DTzschentke/PCBs/EmphaseMainBoard/Project Outputs for EmphaseMainBoard/Import Error Report - EmphaseMainBoard.html

Altium customize

# DXF/DWG File Import Error Report

Date | : | 2012-06-26
Time | : | 17:45:27
Elapsed Time | : | 00:00:00
PCB Filename | : | E:\Projekte\PCBs\EmphaseMainBoard\EmphaseMainBoard.PcbDoc
DXF Filename | : | E:\Orga\CI\NonlinearLabsLogo.dxf

ERROR : The file could not be processed - Can't get current mlstyle
