DTzschentke/PCBs/EmphaseMainBoard/Project Outputs for EmphaseMainBoard/Titelpage.odt

Hardware Documentation

Emphase Keyboard

- Mainboard -

V01 Rev.A 1226 DTZ

printed: 2012-07-03
