DTzschentke/PCBs/_Project/Hardware Interface Overview.pdf

# Emphase Mainboard Hardware Interface Overview

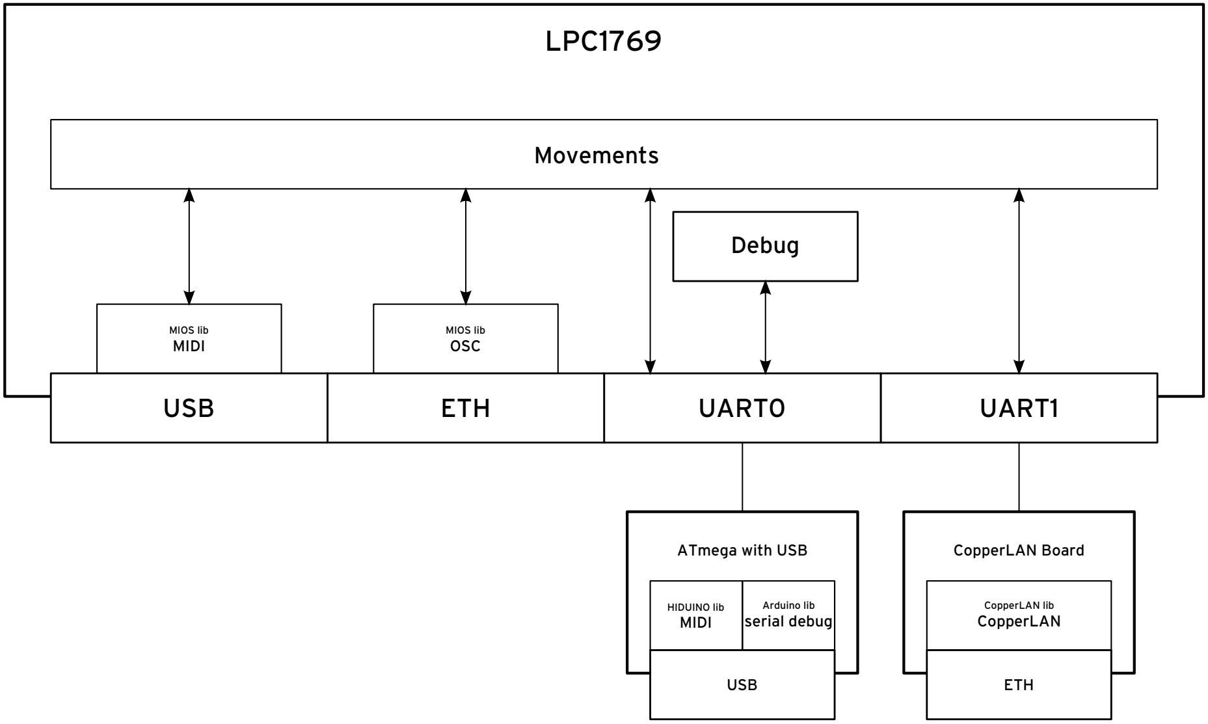
[picture p1: figure]
USB; ETH; UART0; UART1; LPC1769; MIOS lib MIDI; MIOS lib OSC; ATmega with USB; CopperLAN Board; HIDUINO lib MIDI; Arduino lib serial debug; CopperLAN lib CopperLAN; Movements; Debug

2012-07-25 DTZ
