DTzschentke/PCBs/_Project/2012-06-18_ProjektÜbersicht.pdf

# Empahse Hardware Übersicht

Abtastfrequenzen:
2 kHz - 500 µs
2.5 kHz - 400 µs
3.34 kHz - 300 µs
5 | kHz - 200 µs
10 | kHz - 100 µs

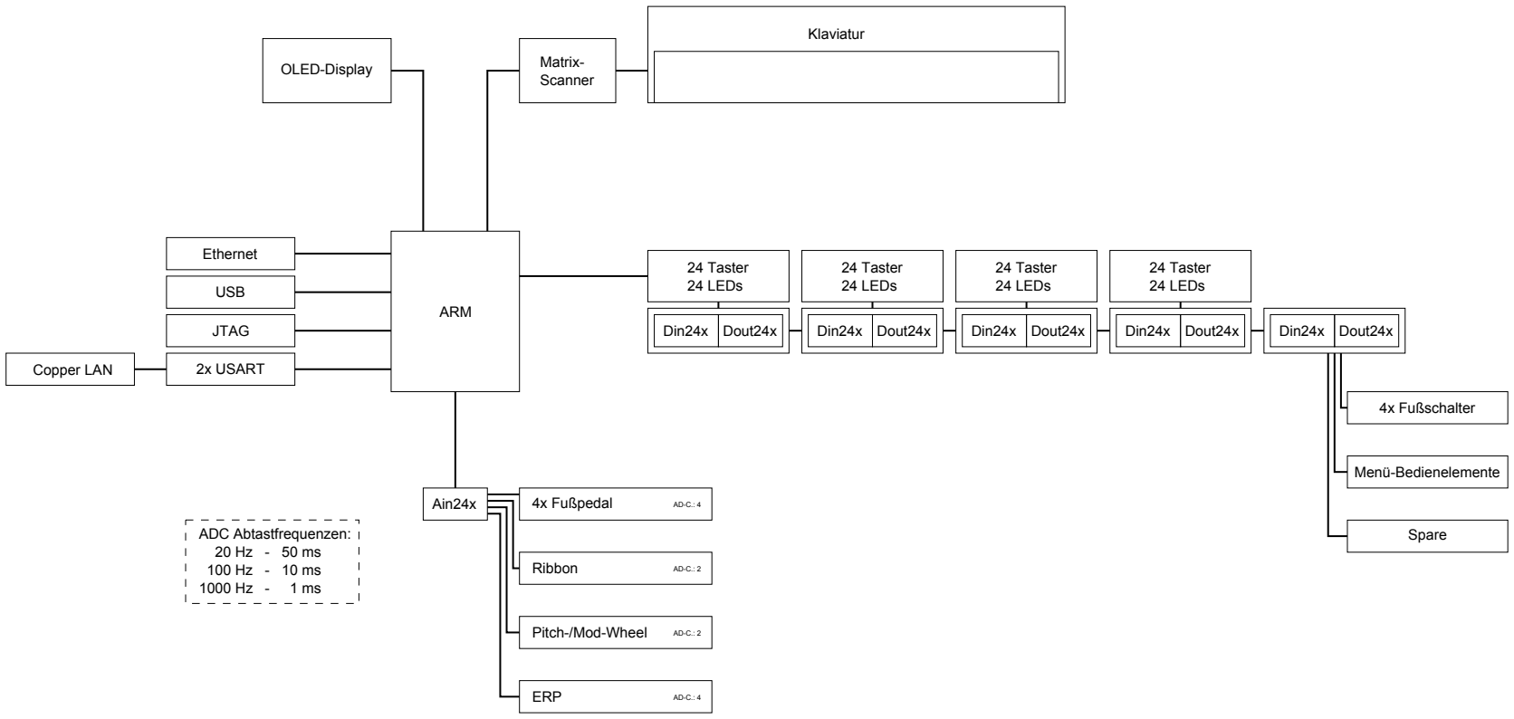
[picture p2: figure]
ARM; OLED-Display; Ethernet; USB; JTAG; Copper LAN; 2x USART; Matrix- Scanner; Klaviatur; Din24x; Dout24x; 24 Taster 24 LEDs; Spare; 4x Fußschalter; Menü-Bedienelemente; Ain24x; 4x Fußpedal; Ribbon; Pitch-/Mod-Wheel; ERP; ADC Abtastfrequenzen: 20 Hz - 50 ms 100 Hz - 10 ms

2012-06-18
