DTzschentke/PCBs/Dout32x/Dout32x.pdf

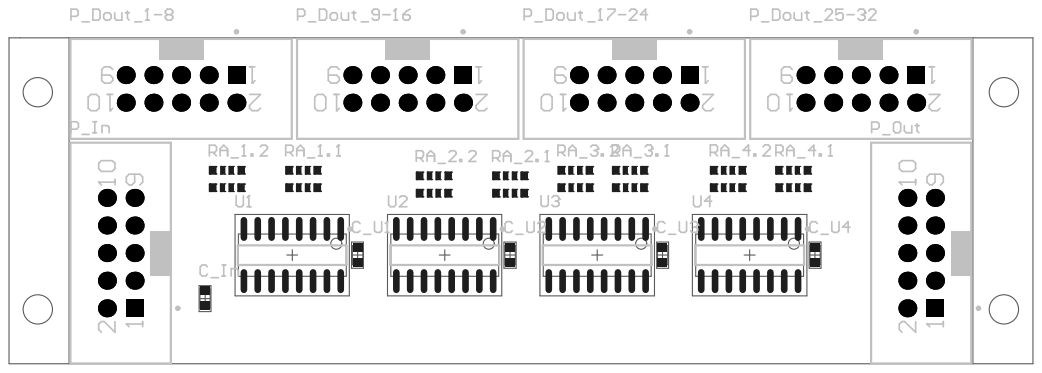
[picture p10: page 1]
