DTzschentke/PCBs/Prototype/Base Board.sch Rev.B.pdf

A

A

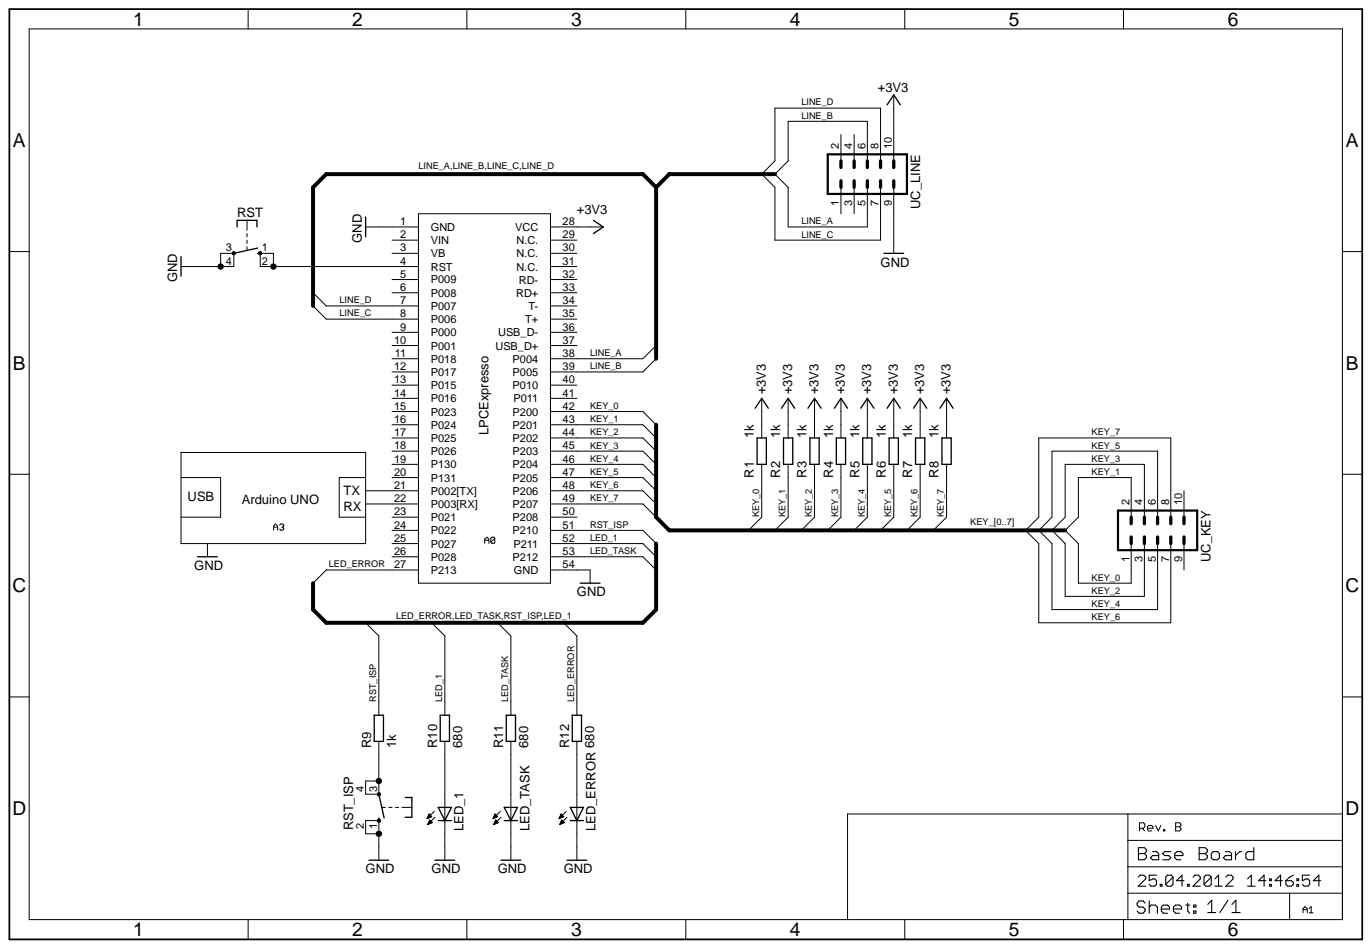
[picture p13: page 1]
