DTzschentke/PCBs/UiBoard/Job1.PDF

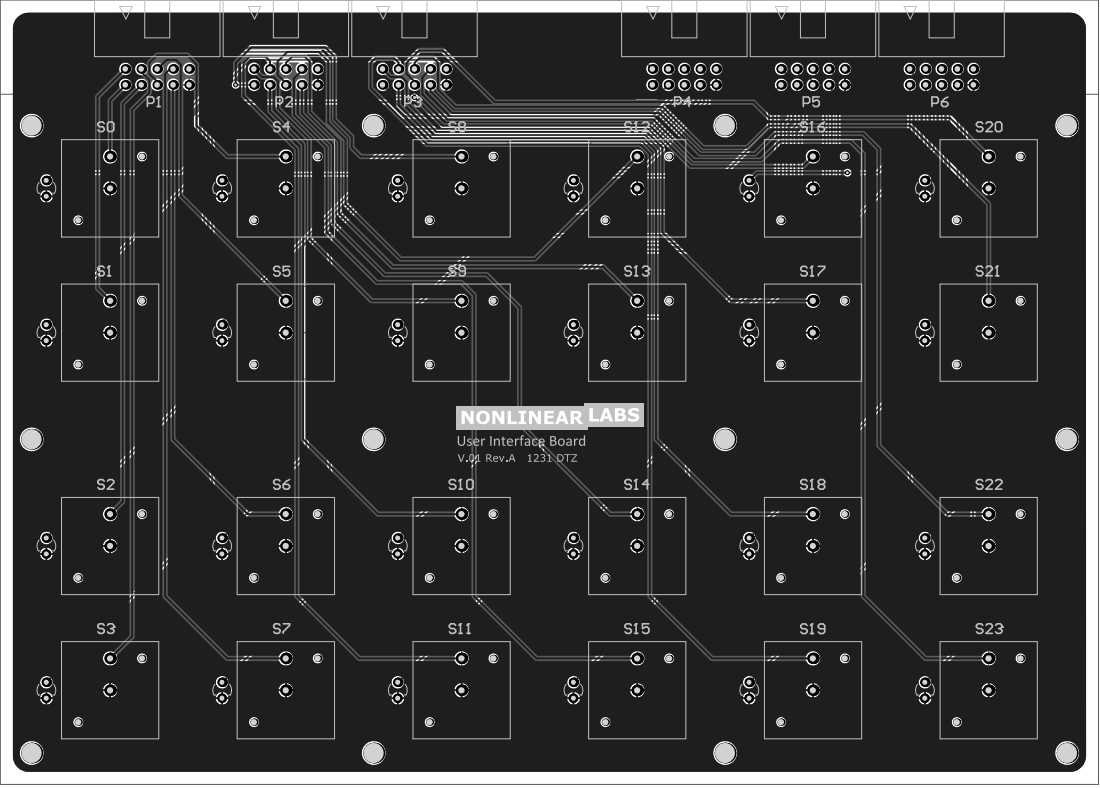
[picture p14: page 1]

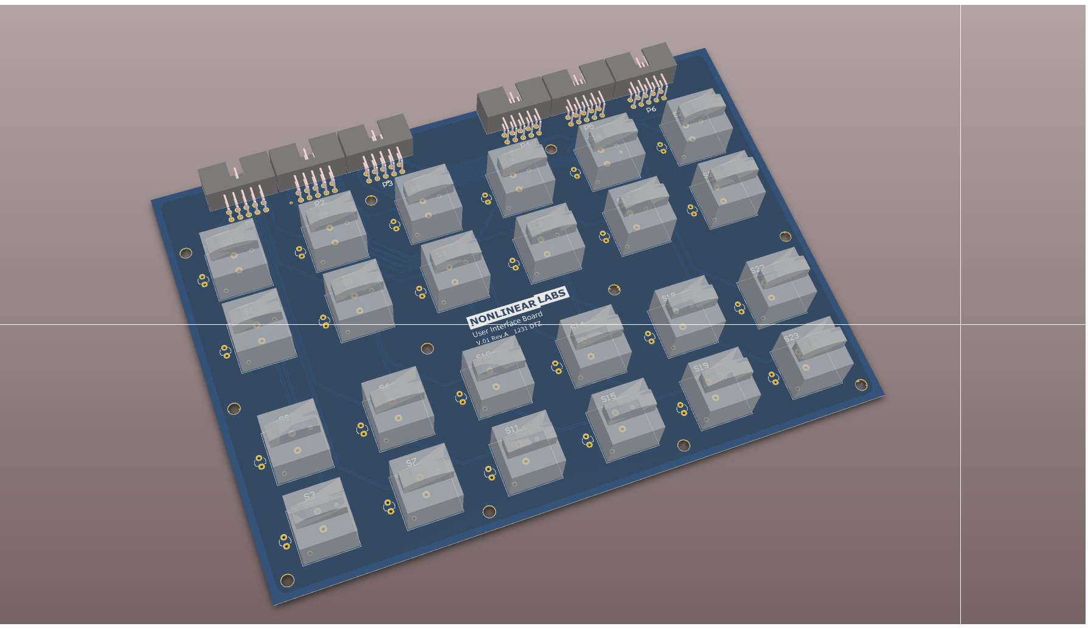
[picture p15: page 2]
