DTzschentke/PCBs/mbhp_core_lpc17_pcb_v1_0/mbhp_core_lpc17_pcb_v1_0/Bottom.pdf

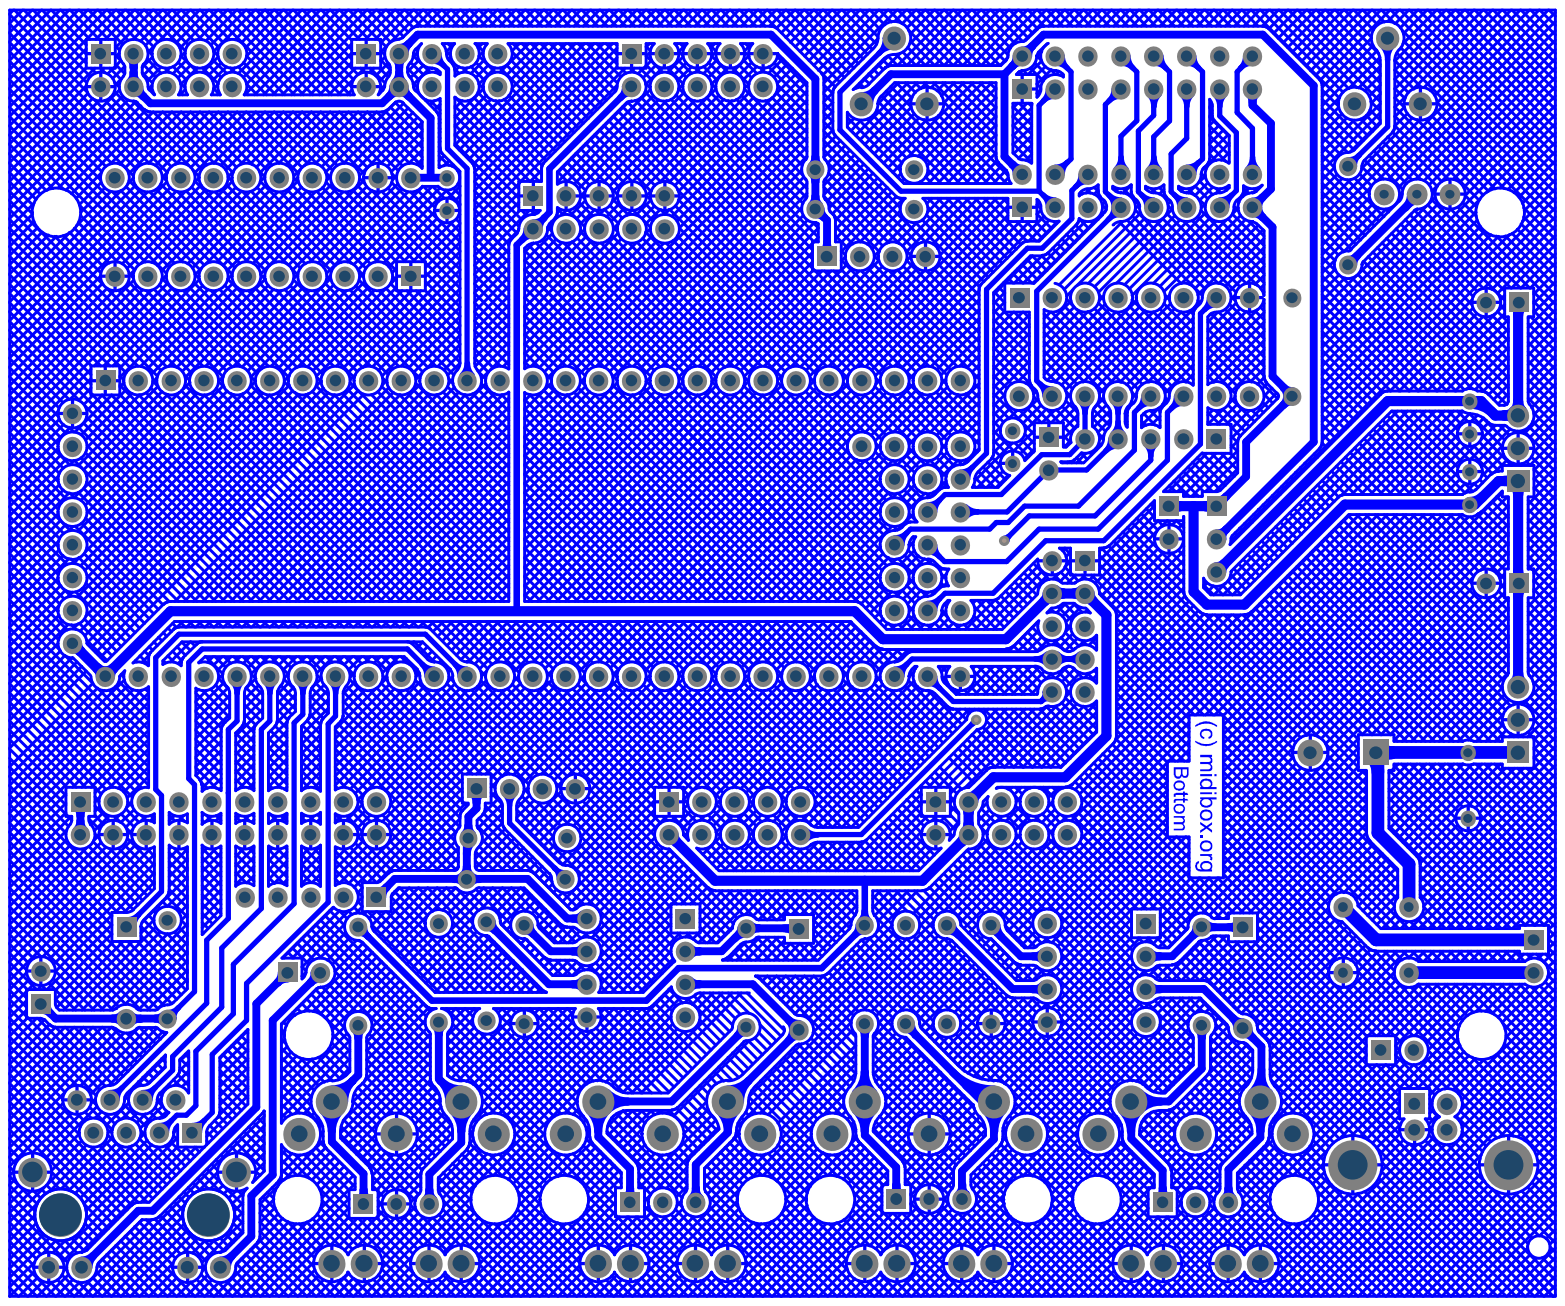
[picture p16: page 1]
