DTzschentke/PCBs/mbhp_core_lpc17_pcb_v1_0/mbhp_core_lpc17_pcb_v1_0/MBHP_CORE_LPC176x.pdf

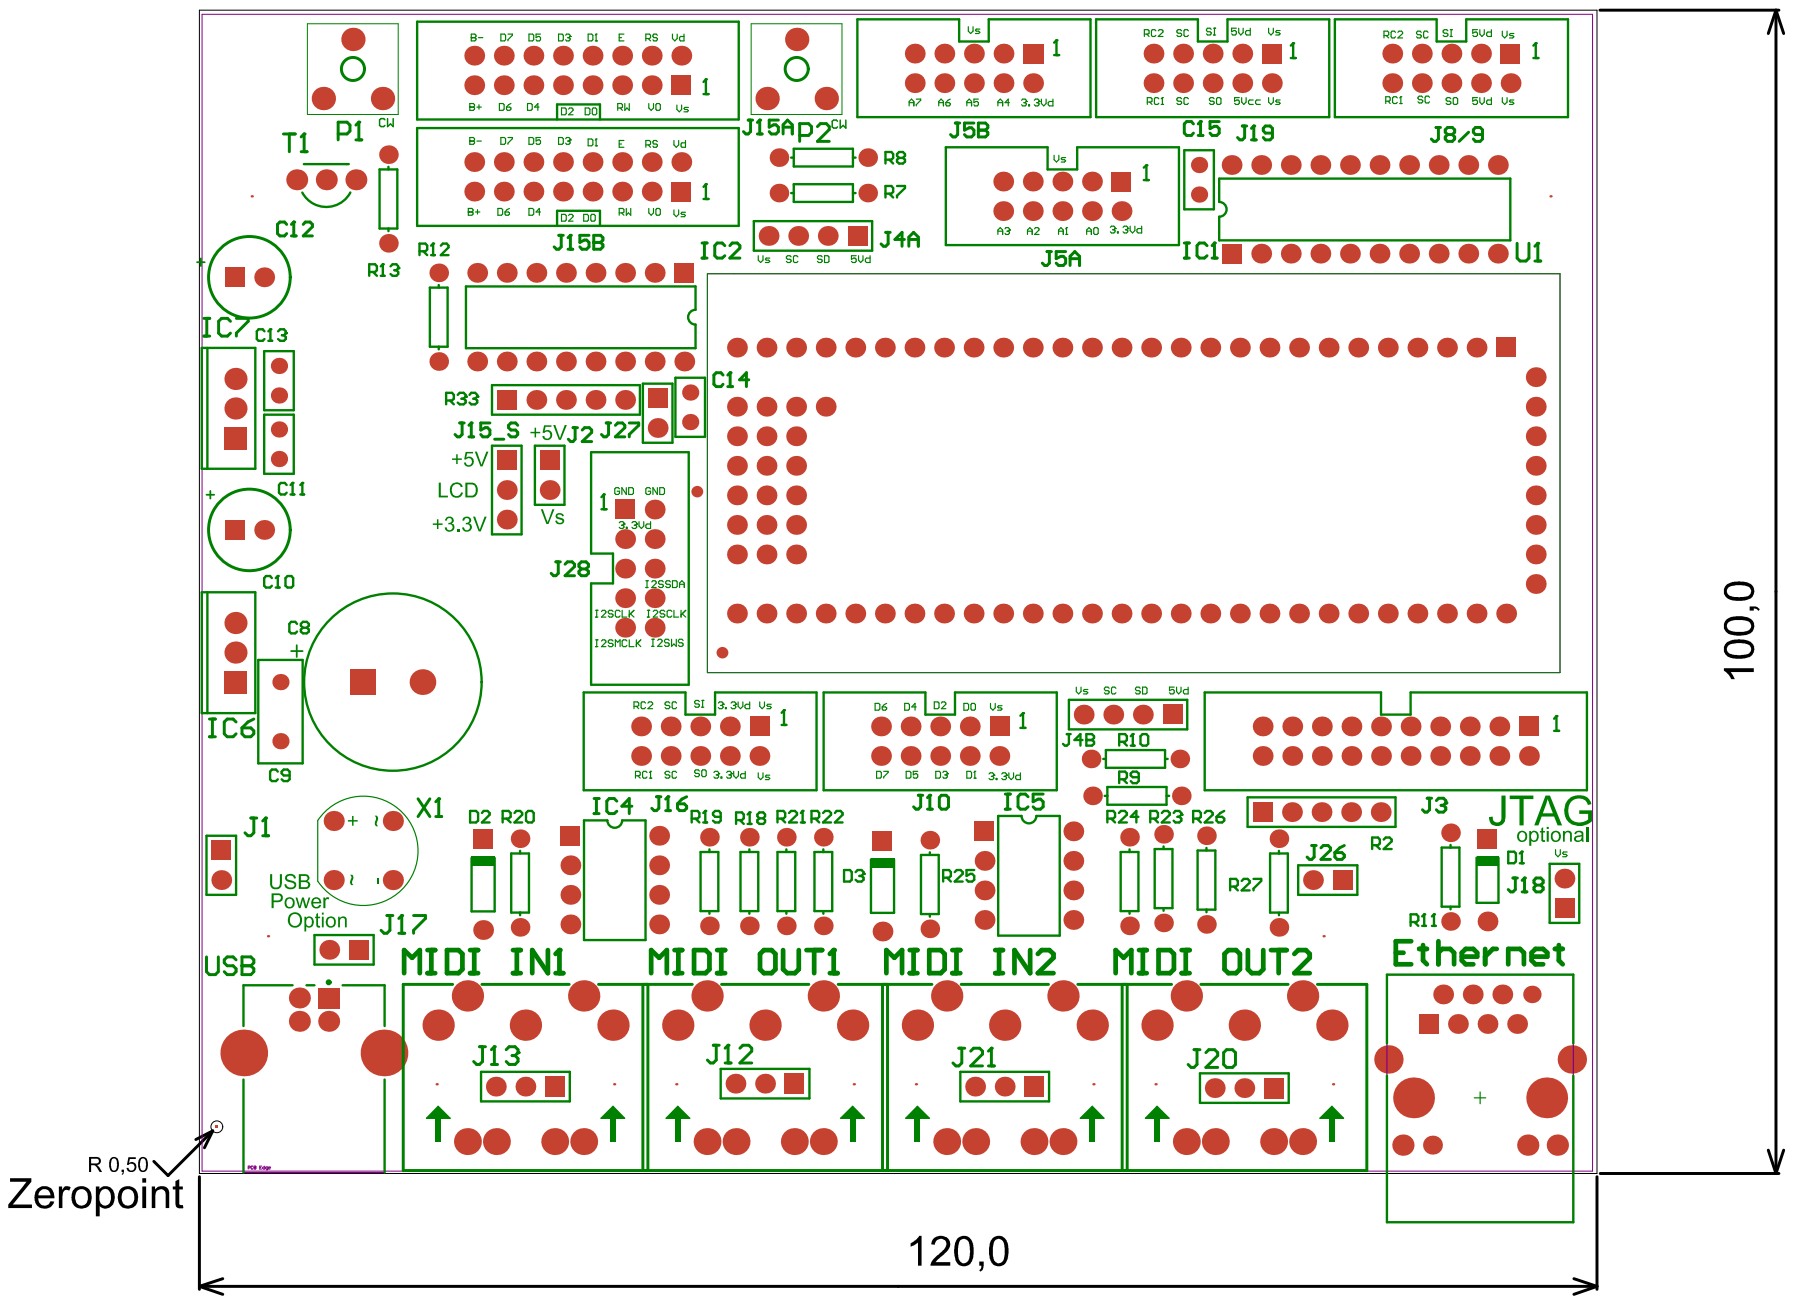
[picture p17: page 1]
