DTzschentke/PCBs/mbhp_core_lpc17_pcb_v1_0/mbhp_core_lpc17_pcb_v1_0/MBHP_CORE_LPC17x.pdf

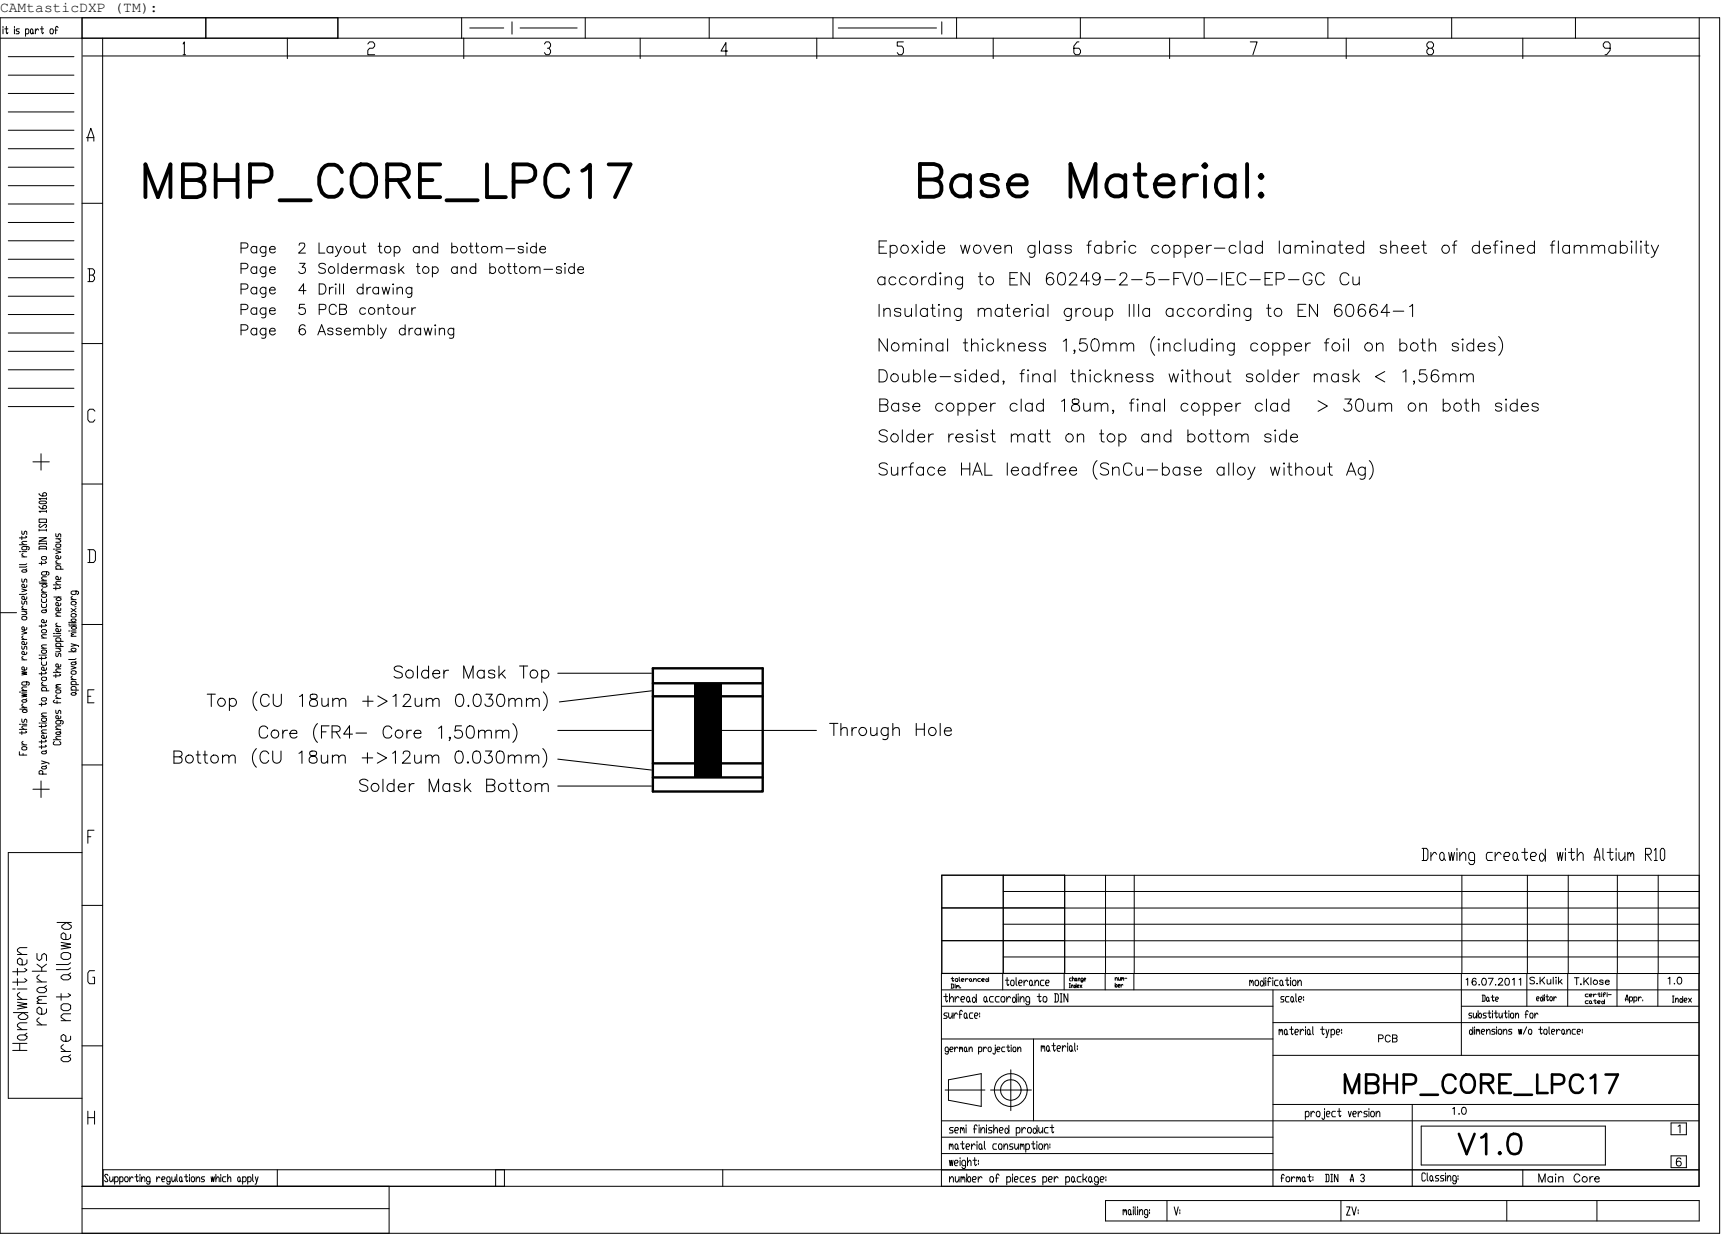
[picture p18: page 1]
CAMtasticDXP (TM):

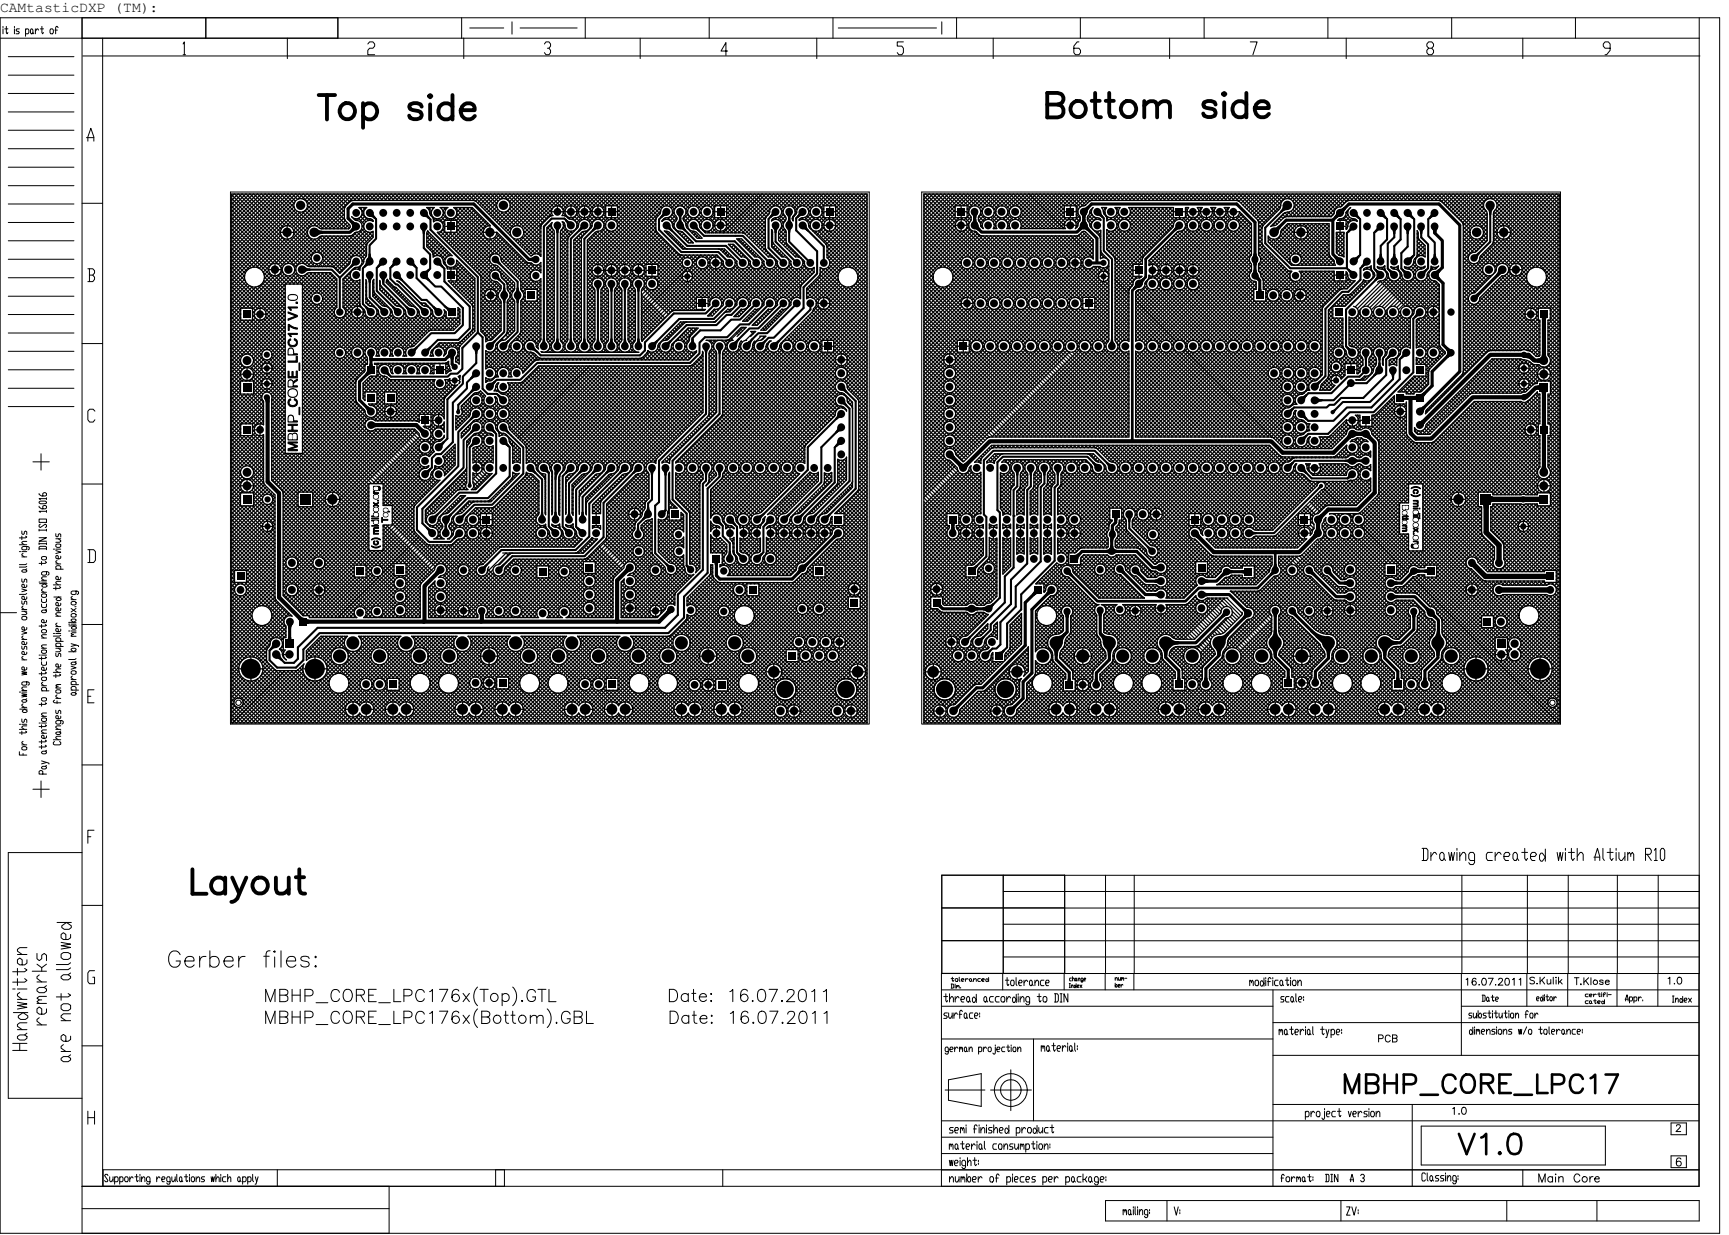
[picture p19: page 2]

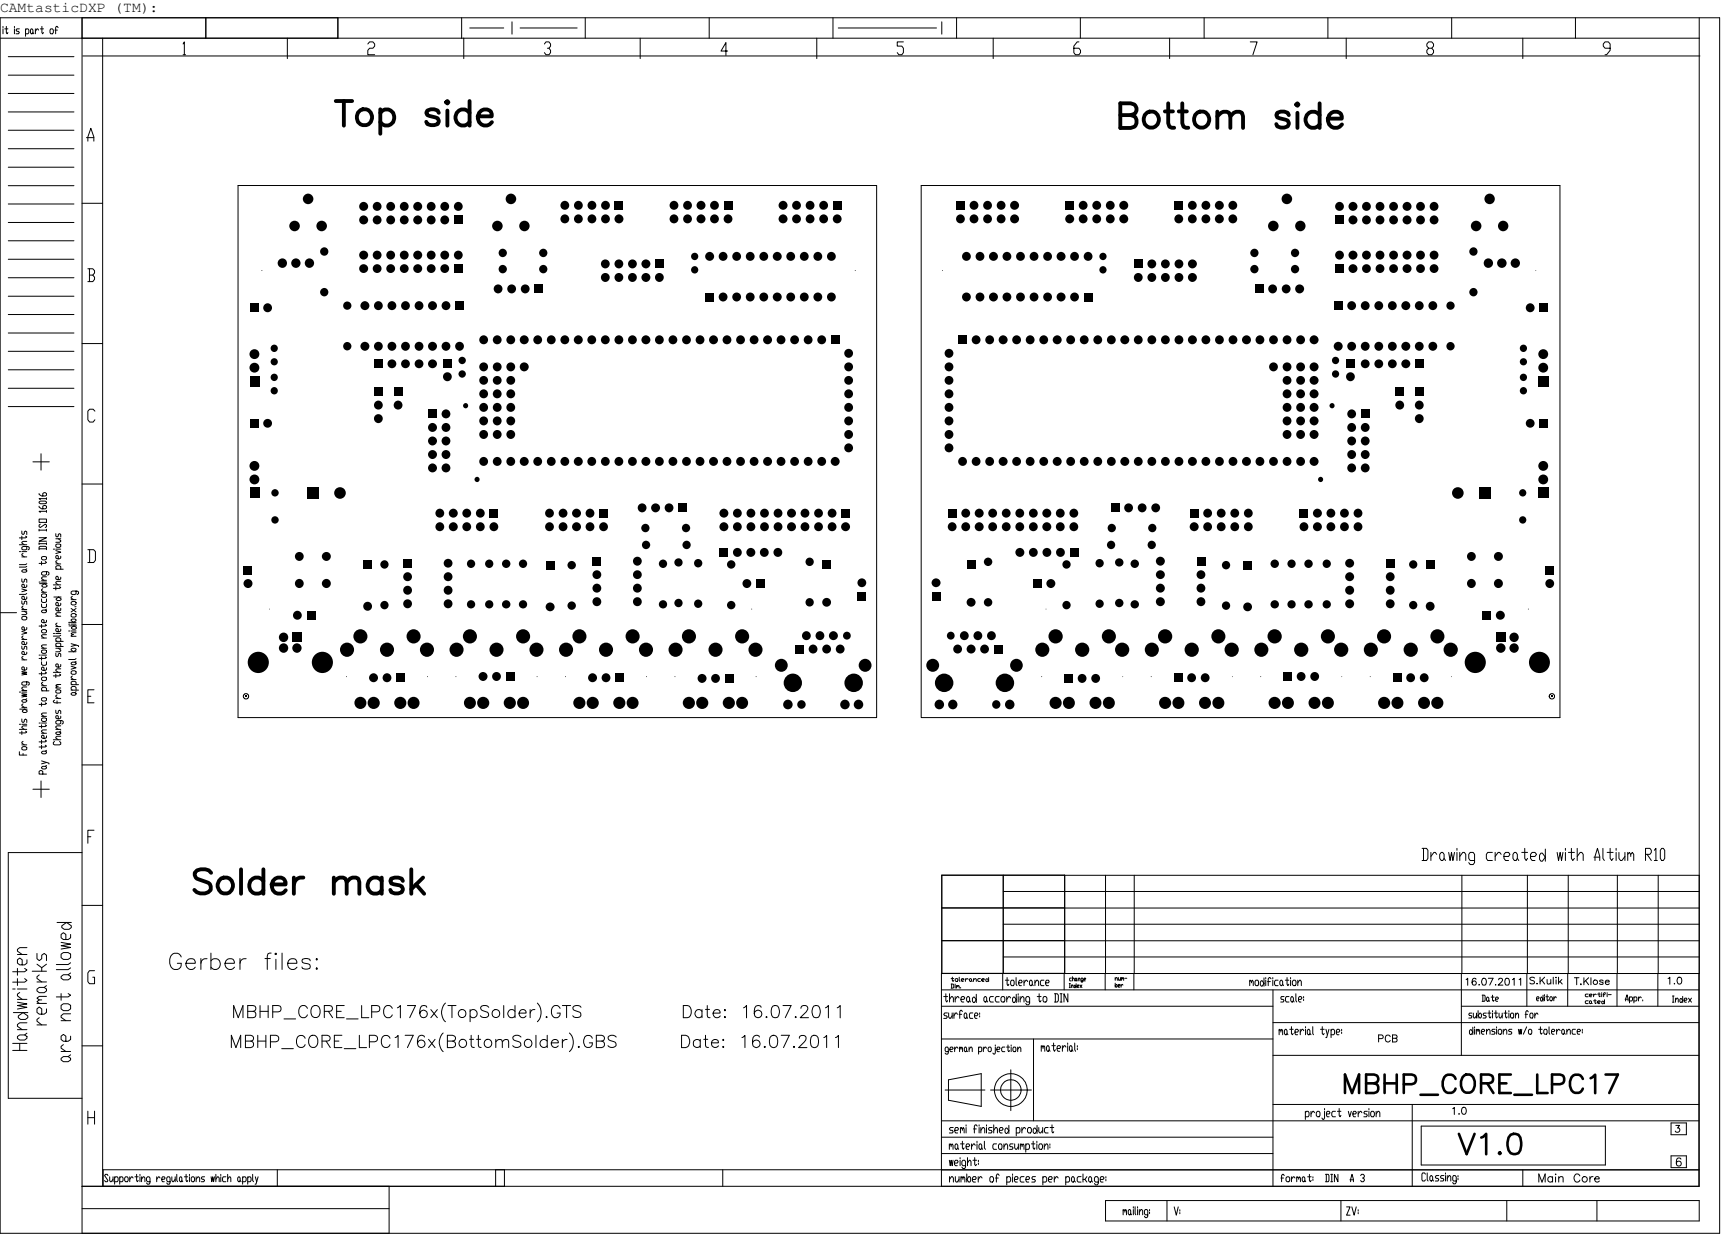
[picture p20: page 3]

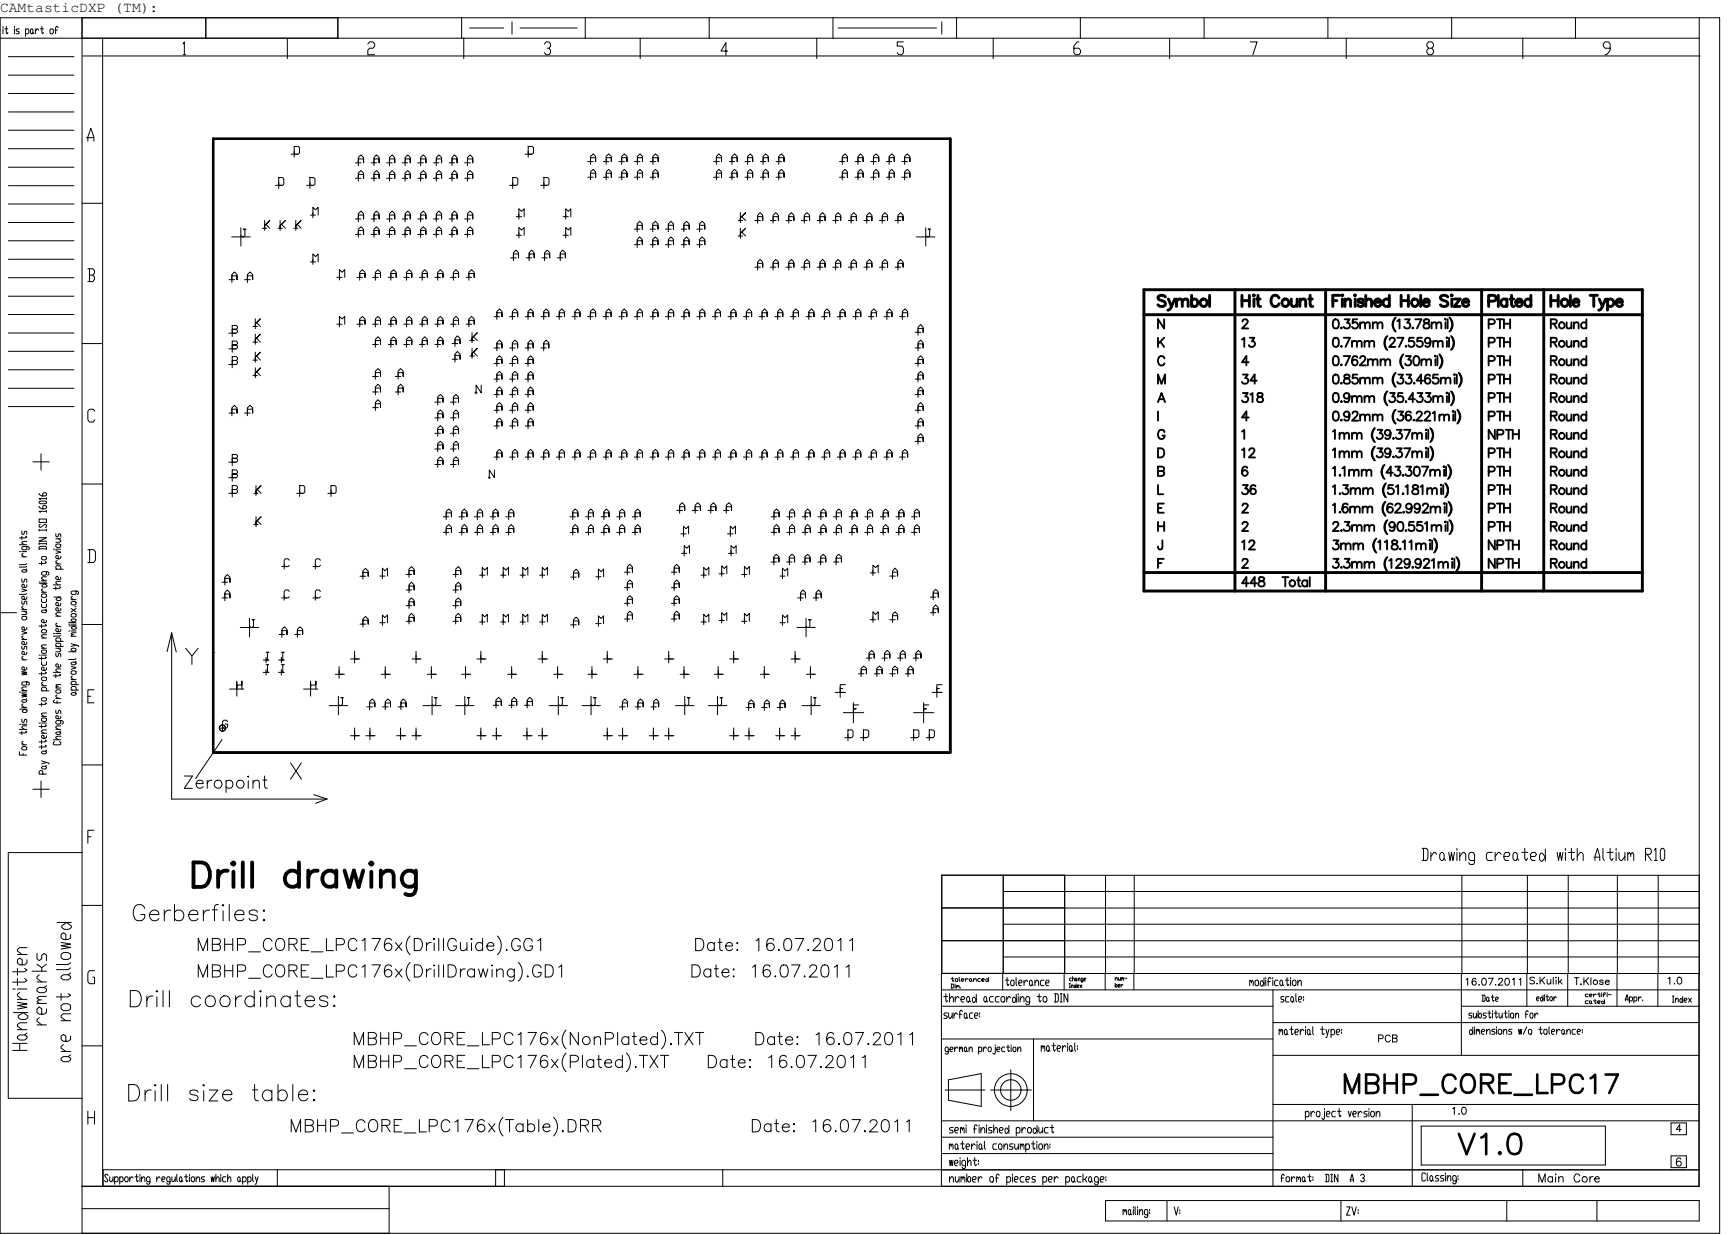
[picture p21: page 4]

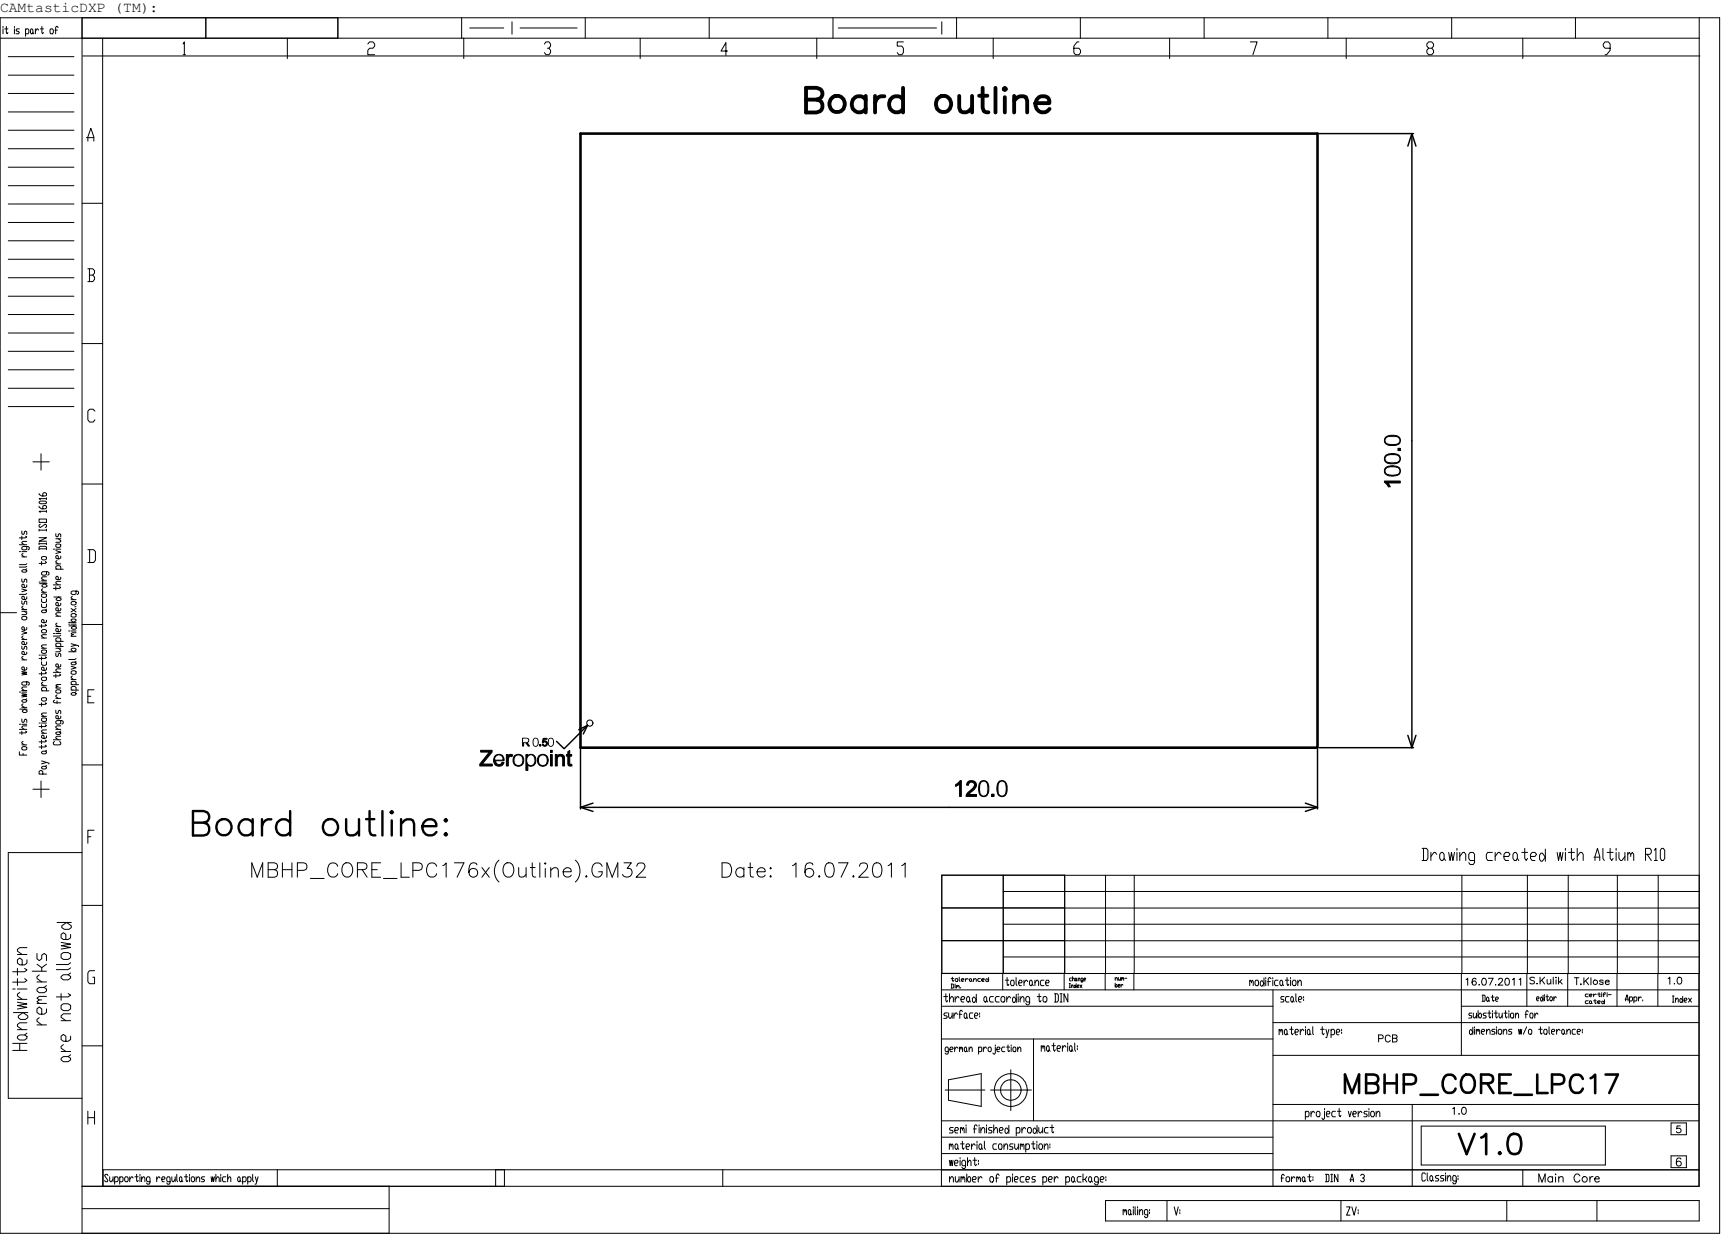
[picture p22: page 5]

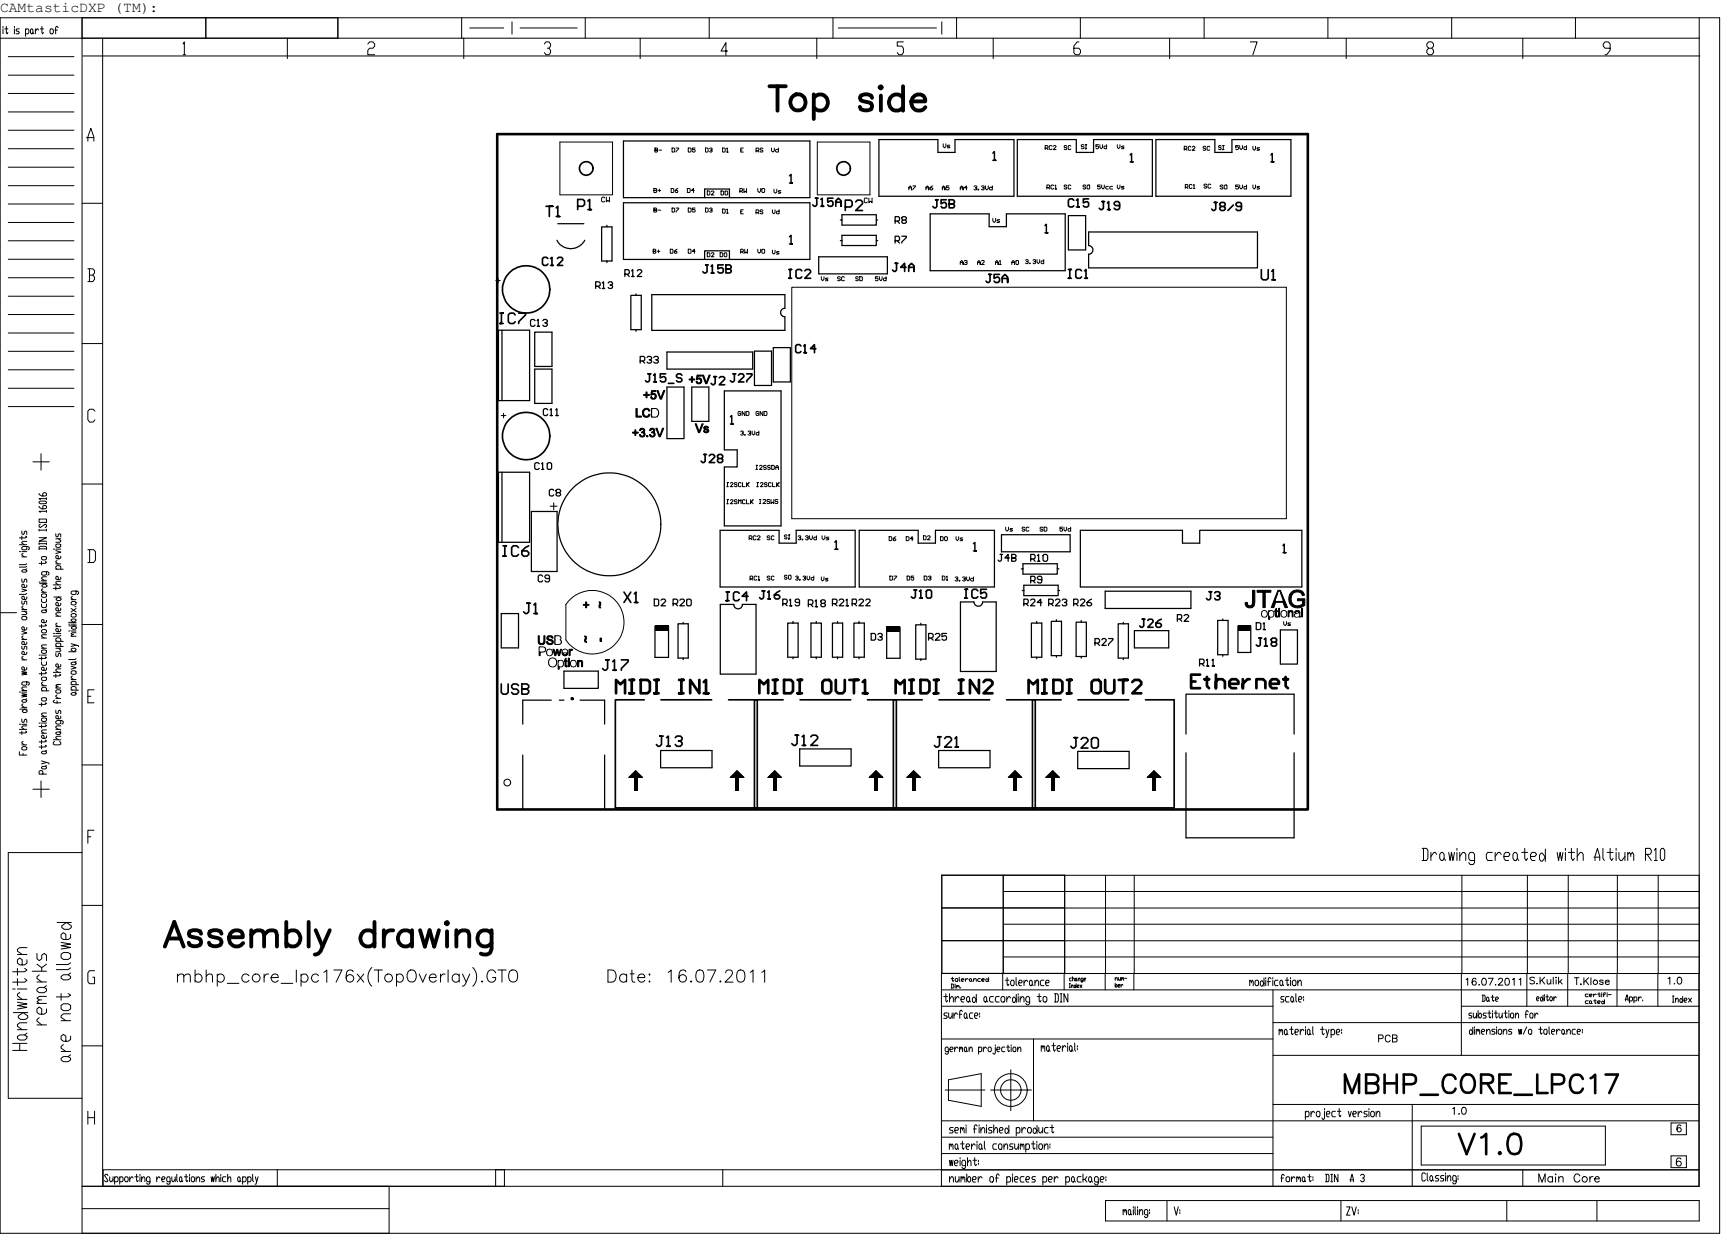
[picture p23: page 6]
