DTzschentke/PCBs/mbhp_core_lpc17_pcb_v1_0/mbhp_core_lpc17_pcb_v1_0/Top.pdf

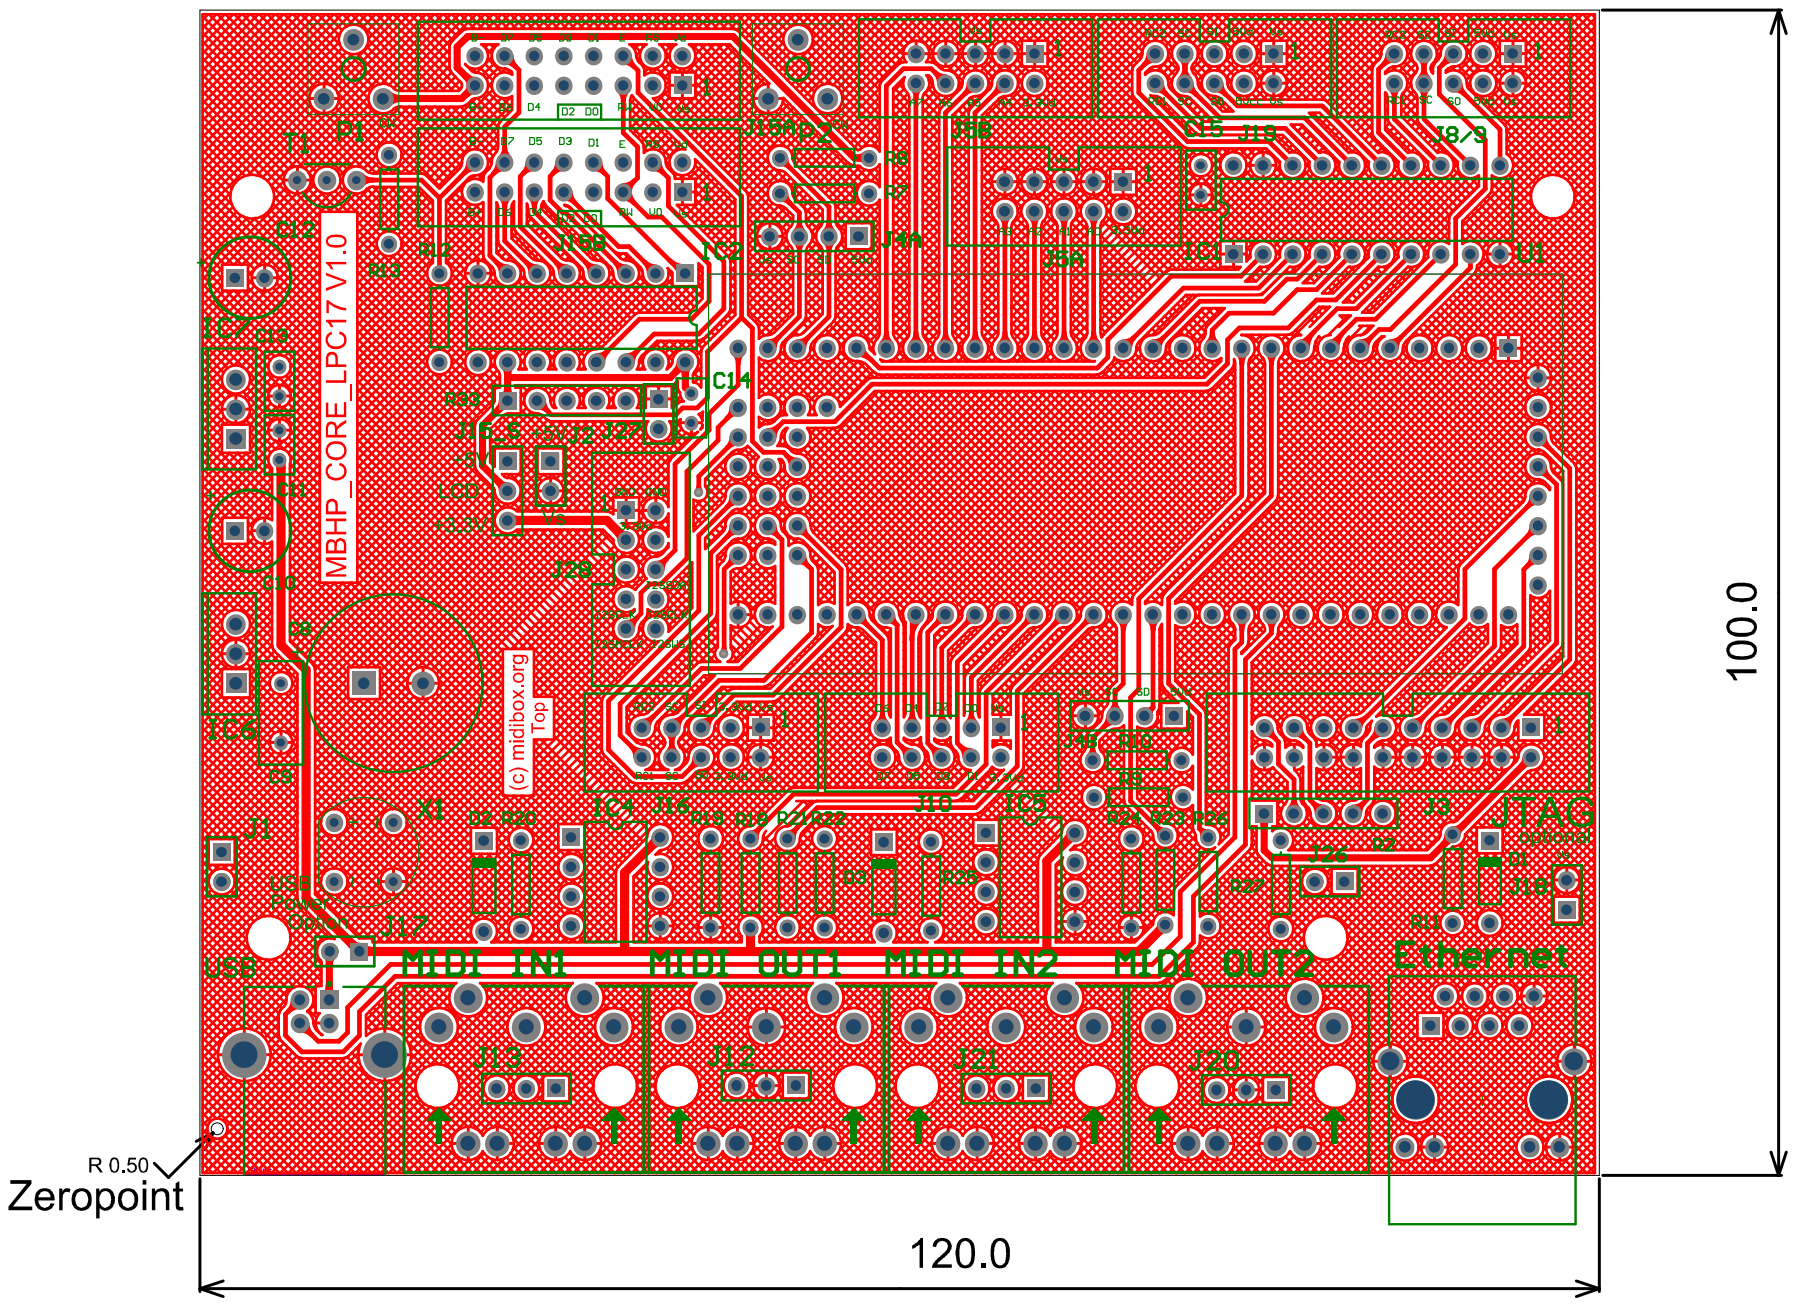
[picture p24: page 1]
