DTzschentke/PCBs/Panel_UI_Din24_Dout24/Project Outputs for Panel_UI_Din24_Dout24/EmphasePanel.PDF

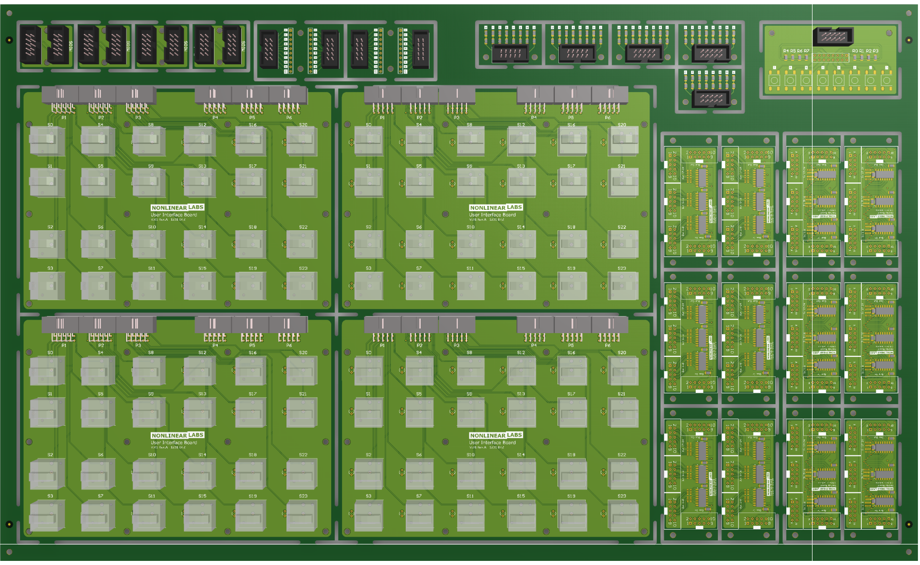
[picture p25: page 1]
