DTzschentke/PCBs/(list of files, drawings)

Other design files:
_Project/Panel.PcbDoc
Adapter/Header-PinHeader.PcbDoc
Adapter/Header-PinHeader.PrjPCB
Adapter/Header-PinHeader.SchDoc
Adapter/LED-Board.PcbDoc
Adapter/LED-Board.PrjPCB
Adapter/LED-Board.SchDoc
Adapter/MIOS-Emphase.PcbDoc
Adapter/MIOS-Emphase.PrjPCB
Adapter/MIOS-Emphase.SchDoc
ButtonBoard/ButtonBoard.PcbDoc
ButtonBoard/ButtonBoard.PrjPCB
ButtonBoard/ButtonBoard.SchDoc
Din24x/Din24x..SchDoc
Din24x/Din24x.PcbDoc
Din24x/Din24x.PrjPCB
Din24x/Din24x.SchDoc
Din24x/Din24xOLD..SchDoc
Din24x/Din24xOLD.PcbDoc
Din24x/History/Din24x.~(11).SchDoc/Din24x.~(11).SchDoc
Dout24x/Dout24x.PcbDoc
Dout24x/Dout24x.PrjPCB
Dout24x/Dout24x.SchDoc
Dout24x/Dout24xXXX.PcbDoc
Dout24x/History/Dout24x.~(6).PcbDoc/Dout24x.~(6).PcbDoc
Dout24x/History/Dout24x.~(8).PcbDoc/Dout24x.~(8).PcbDoc
Dout24x/History/Dout24x.~(13).SchDoc/Dout24x.~(13).SchDoc
Dout32x/Dout32x.PcbDoc
Dout32x/Dout32x.PrjPCB
Dout32x/Dout32x.SchDoc
EmphaseMainBoard/EmphaseMainBoard.PcbDoc
EmphaseMainBoard/EmphaseMainBoard.PrjPCB
EmphaseMainBoard/EmphaseMainBoard.SchDoc
EmphaseMainBoard/EmphaseMainBoardX.PcbDoc
EmphaseMainBoard/Gesamtübersicht.SchDoc
mbhp_core_lpc17_pcb_v1_0/mbhp_core_lpc17_pcb_v1_0/MBHP_CORE_LPC176x.PcbDoc
mbhp_core_lpc17_pcb_v1_0/mbhp_core_lpc17_pcb_v1_0/MBHP_CORE_LPC176x.PrjPcb
Panel_UI_Din24_Dout24/Panel_UI_Din24_Dout24.PcbDoc
Panel_UI_Din24_Dout24/Panel_UI_Din24_Dout24.PrjPCB
UiBoard/UiBoard.PcbDoc
UiBoard/UiBoard.PrjPCB
UiBoard/UiBoard.SchDoc
