DTzschentke/PCBs/Prototype/Base Board RevD.sch

## EAGLE design Prototype/Base Board RevD.sch (2012-08-02)

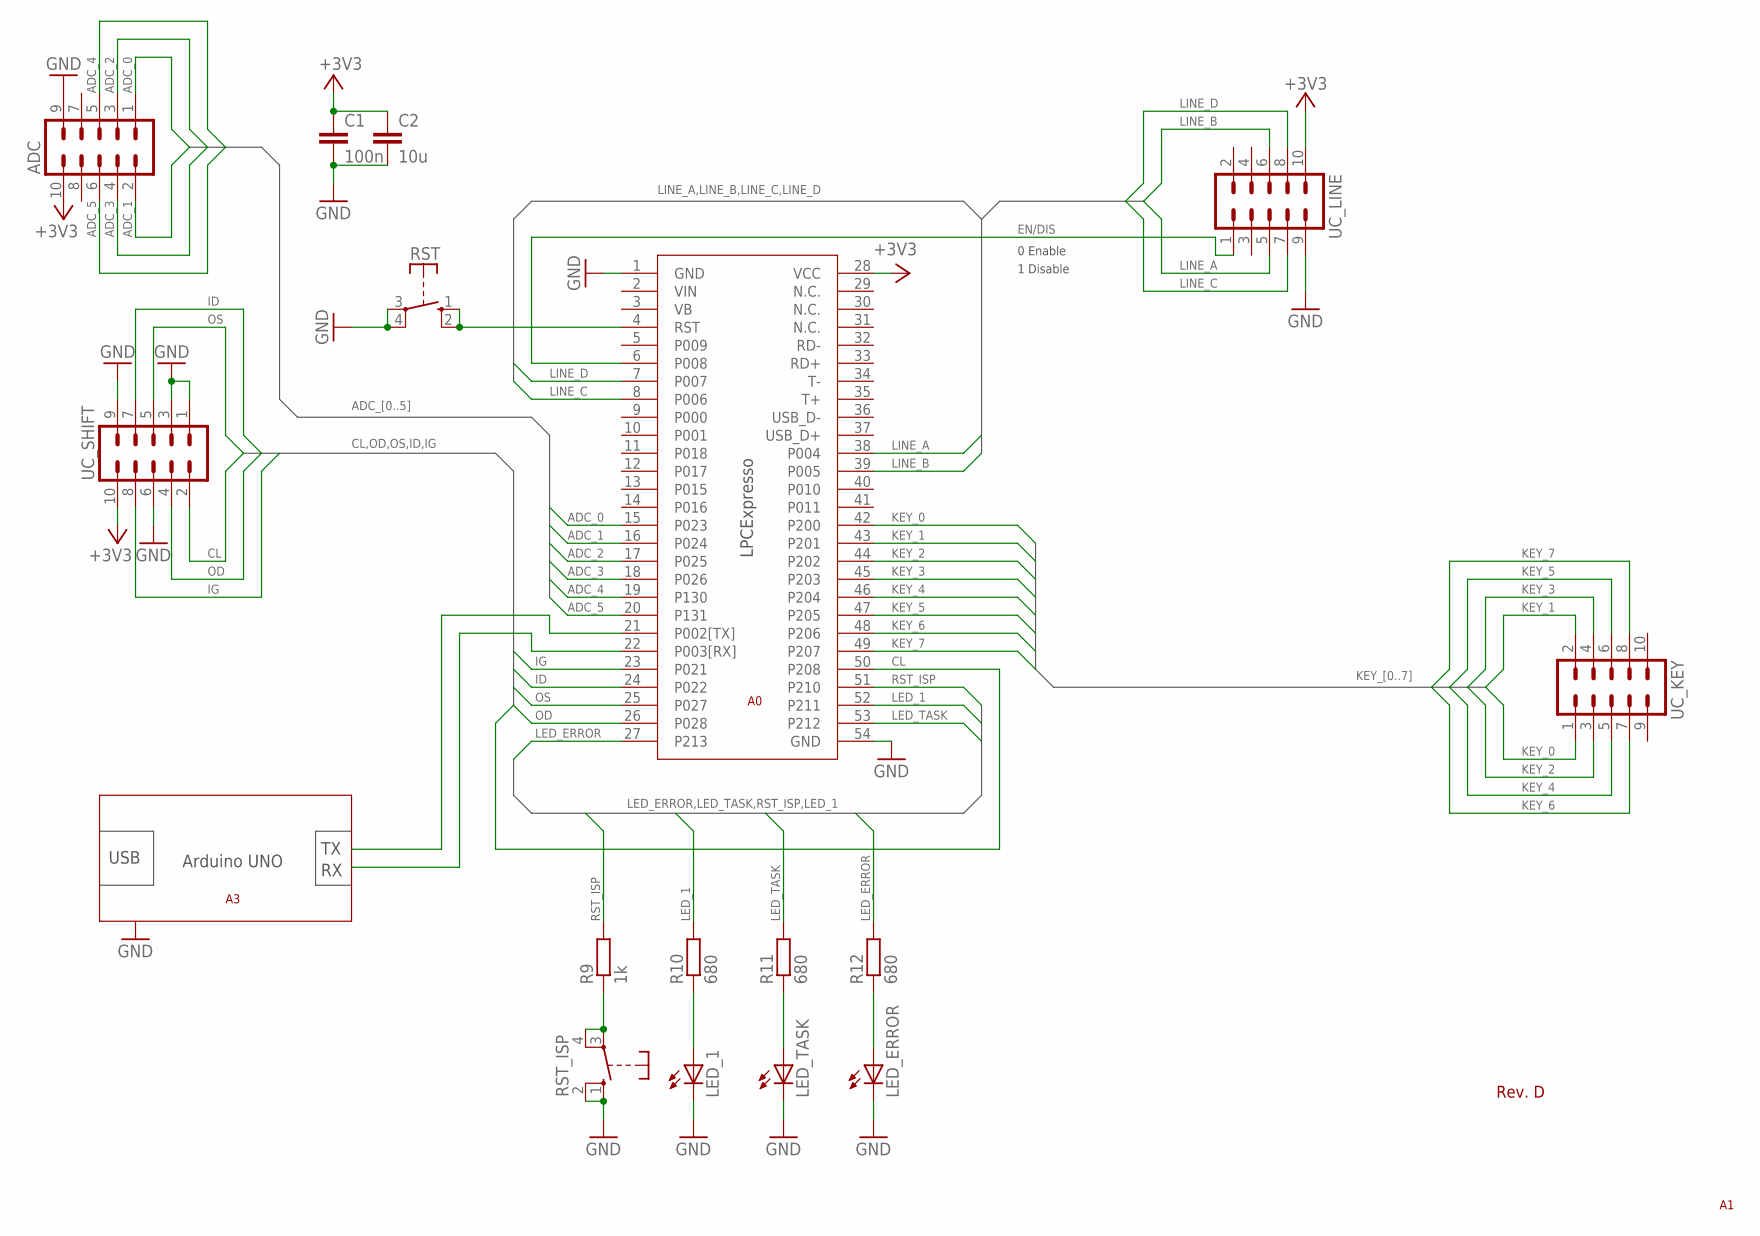
[picture p27: schematic Base Board RevD.sch]

Parts:
ADC: ML10
C1: 100n; C025-024X044
C2: 10u; C025-024X044
LED_1: LED5MM
LED_ERROR: LED5MM
LED_TASK: LED5MM
R9: 1k; 0204/5
R10, R11, R12: 680; 0204/5
RST: DT6
RST_ISP: DT6
U$1: LPCEXPRESSO
UC_KEY: ML10
UC_LINE: ML10
UC_SHIFT: ML10

Connections:
+3V3: ADC.10, C1.1, C2.1, U$1.28 (VCC), UC_LINE.10, UC_SHIFT.10
ADC_0: ADC.1, U$1.15 (P023)
ADC_1: ADC.2, U$1.16 (P024)
ADC_2: ADC.3, U$1.17 (P025)
ADC_3: ADC.4, U$1.18 (P026)
ADC_4: ADC.5, U$1.19 (P130)
ADC_5: ADC.6, U$1.20 (P131)
CL: U$1.50 (P208), UC_SHIFT.2
EN/DIS: U$1.6 (P008), UC_LINE.1
GND: ADC.9, C1.2, C2.2, LED_1.K (C), LED_ERROR.K (C), LED_TASK.K (C), RST.3, RST.4, RST_ISP.1 (S), RST_ISP.2 (S), U$1.1 (GND), U$1.54 (GND), UC_LINE.9, UC_SHIFT.1, UC_SHIFT.3, UC_SHIFT.6, UC_SHIFT.9
ID: U$1.24 (P022), UC_SHIFT.7
IG: U$1.23 (P021), UC_SHIFT.8
KEY_0: U$1.42 (P200), UC_KEY.1
KEY_1: U$1.43 (P201), UC_KEY.2
KEY_2: U$1.44 (P202), UC_KEY.3
KEY_3: U$1.45 (P203), UC_KEY.4
KEY_4: U$1.46 (P204), UC_KEY.5
KEY_5: U$1.47 (P205), UC_KEY.6
KEY_6: U$1.48 (P206), UC_KEY.7
KEY_7: U$1.49 (P207), UC_KEY.8
LED_1: R10.2, U$1.52 (P211)
LED_ERROR: R12.2, U$1.27 (P213)
LED_TASK: R11.2, U$1.53 (P212)
LINE_A: U$1.38 (P004), UC_LINE.5
LINE_B: U$1.39 (P005), UC_LINE.6
LINE_C: U$1.8 (P006), UC_LINE.7
LINE_D: U$1.7, UC_LINE.8
unnamed: RST.1 (S), RST.2 (S), U$1.4 (RST)
unnamed: LED_ERROR.A, R12.1
unnamed: LED_TASK.A, R11.1
unnamed: LED_1.A, R10.1
unnamed: R9.1, RST_ISP.3, RST_ISP.4
OD: U$1.26 (P028), UC_SHIFT.4
OS: U$1.25 (P027), UC_SHIFT.5
RST_ISP: R9.2, U$1.51 (P210)

Notes on the sheet:
Arduino UNO
USB
Rev. D
0 Enable
1 Disable
