DTzschentke/PCBs/Prototype/Base Board.sch

## EAGLE design Prototype/Base Board.sch (2012-08-02)

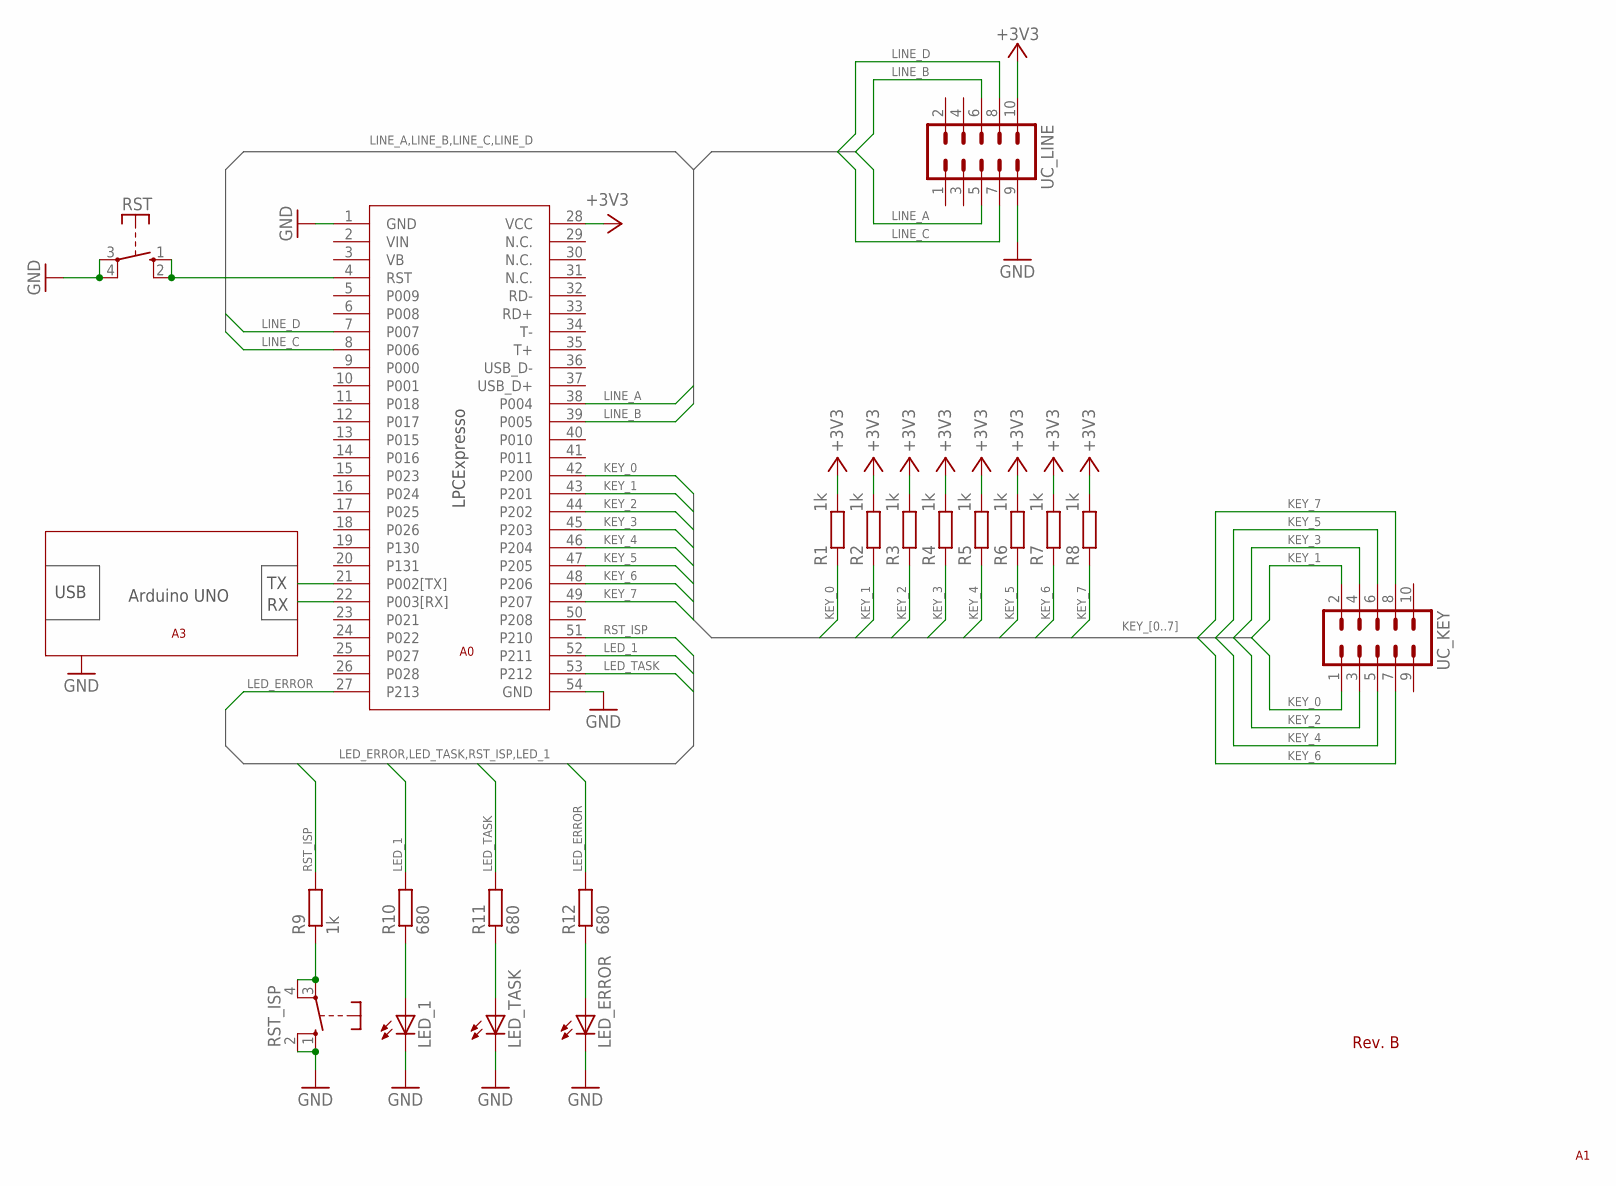
[picture p28: schematic Base Board.sch]

Parts:
LED_1: LED5MM
LED_ERROR: LED5MM
LED_TASK: LED5MM
R1, R2, R3, R4, R5, R6, R7, R8, R9: 1k; 0204/5
R10, R11, R12: 680; 0204/5
RST: DT6
RST_ISP: DT6
U$1: LPCEXPRESSO
UC_KEY: ML10
UC_LINE: ML10

Connections:
+3V3: R1.1, R2.1, R3.1, R4.1, R5.1, R6.1, R7.1, R8.1, U$1.28 (VCC), UC_LINE.10
GND: LED_1.K (C), LED_ERROR.K (C), LED_TASK.K (C), RST.3, RST.4, RST_ISP.1 (S), RST_ISP.2 (S), U$1.1 (GND), U$1.54 (GND), UC_LINE.9
KEY_0: R1.2, U$1.42 (P200), UC_KEY.1
KEY_1: R2.2, U$1.43 (P201), UC_KEY.2
KEY_2: R3.2, U$1.44 (P202), UC_KEY.3
KEY_3: R4.2, U$1.45 (P203), UC_KEY.4
KEY_4: R5.2, U$1.46 (P204), UC_KEY.5
KEY_5: R6.2, U$1.47 (P205), UC_KEY.6
KEY_6: R7.2, U$1.48 (P206), UC_KEY.7
KEY_7: R8.2, U$1.49 (P207), UC_KEY.8
LED_1: R10.2, U$1.52 (P211)
LED_ERROR: R12.2, U$1.27 (P213)
LED_TASK: R11.2, U$1.53 (P212)
LINE_A: U$1.38 (P004), UC_LINE.5
LINE_B: U$1.39 (P005), UC_LINE.6
LINE_C: U$1.8 (P006), UC_LINE.7
LINE_D: U$1.7, UC_LINE.8
unnamed: RST.1 (S), RST.2 (S), U$1.4 (RST)
unnamed: LED_ERROR.A, R12.1
unnamed: LED_TASK.A, R11.1
unnamed: LED_1.A, R10.1
unnamed: R9.1, RST_ISP.3, RST_ISP.4
RST_ISP: R9.2, U$1.51 (P210)

Notes on the sheet:
Arduino UNO
USB
Rev. B
