DTzschentke/PCBs/Prototype/Button Board RevA.sch

## EAGLE design Prototype/Button Board RevA.sch (2012-08-02)

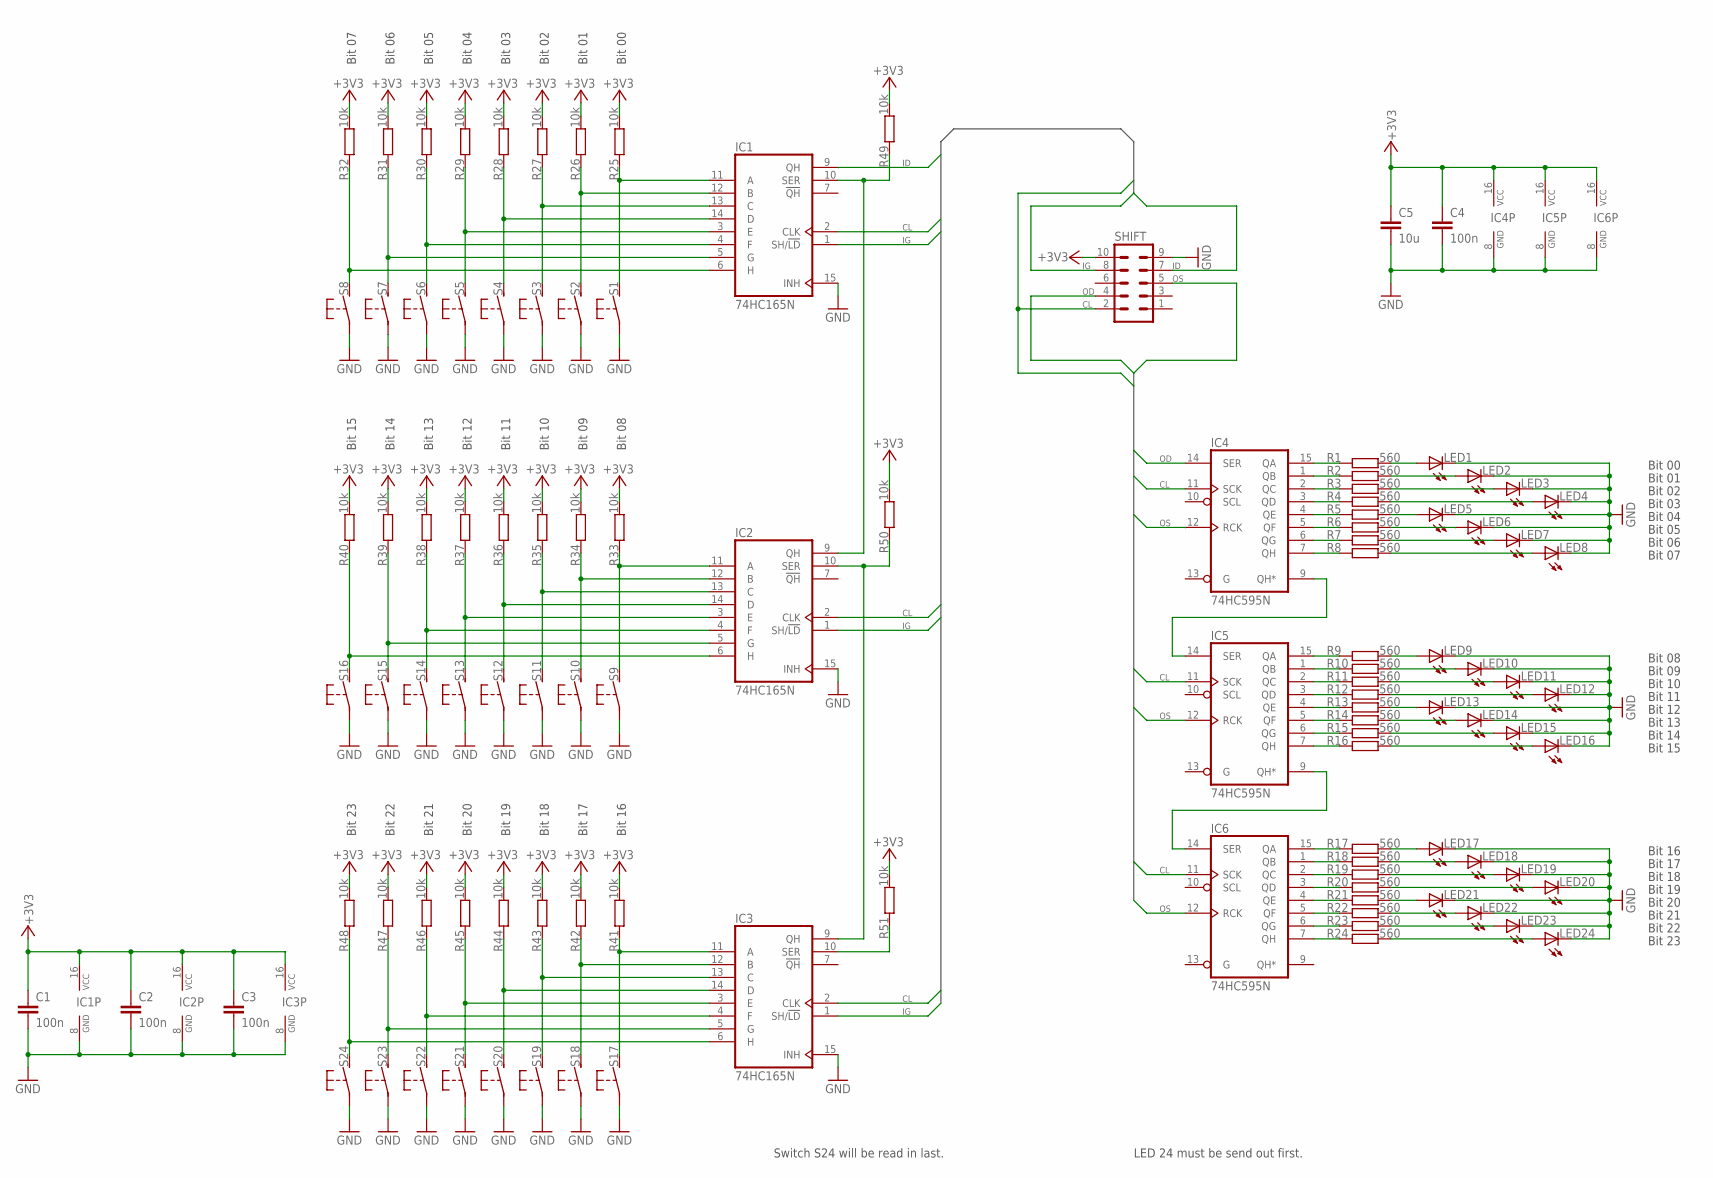
[picture p29: schematic Button Board RevA.sch]

Parts:
C1, C2, C3, C4: 100n; C025-025X050
C5: 10u; C025-025X050
IC1, IC2, IC3: 74HC165N; DIL16
IC4, IC5, IC6: 74HC595N; DIL16
LED1, LED2, LED3, LED4, LED5, LED6, LED7, LED8, LED9, LED10, LED11, LED12, LED13, LED14, LED15, LED16, LED17, LED18, LED19, LED20, LED21, LED22, LED23, LED24: LED3MM
R1, R2, R3, R4, R5, R6, R7, R8, R9, R10, R11, R12, R13, R14, R15, R16, R17, R18, R19, R20, R21, R22, R23, R24: 560; 0204/5
R25, R26, R27, R28, R29, R30, R31, R32, R33, R34, R35, R36, R37, R38, R39, R40, R41, R42, R43, R44, R45, R46, R47, R48, R49, R50, R51: 10k; 0204/5
S1, S2, S3, S4, S5, S6, S7, S8, S9, S10, S11, S12, S13, S14, S15, S16, S17, S18, S19, S20, S21, S22, S23, S24: 31-XX; B3F-31XX
SHIFT: ML10

Connections:
+3V3: C1.1, C2.1, C3.1, C4.1, C5.1, IC1.16 (VCC), IC2.16 (VCC), IC3.16 (VCC), IC4.16 (VCC), IC5.16 (VCC), IC6.16 (VCC), R25.2, R26.2, R27.2, R28.2, R29.2, R30.2, R31.2, R32.2, R33.2, R34.2, R35.2, R36.2, R37.2, R38.2, R39.2, R40.2, R41.2, R42.2, R43.2, R44.2, R45.2, R46.2, R47.2, R48.2, R49.2, R50.2, R51.2, SHIFT.10
CL: IC1.2 (CLK), IC2.2 (CLK), IC3.2 (CLK), IC4.11 (SCK), IC5.11 (SCK), IC6.11 (SCK), SHIFT.2
GND: C1.2, C2.2, C3.2, C4.2, C5.2, IC1.8 (GND), IC1.15 (INH), IC2.8 (GND), IC2.15 (INH), IC3.8 (GND), IC3.15 (INH), IC4.8 (GND), IC5.8 (GND), IC6.8 (GND), LED1.K (C), LED2.K (C), LED3.K (C), LED4.K (C), LED5.K (C), LED6.K (C), LED7.K (C), LED8.K (C), LED9.K (C), LED10.K (C), LED11.K (C), LED12.K (C), LED13.K (C), LED14.K (C), LED15.K (C), LED16.K (C), LED17.K (C), LED18.K (C), LED19.K (C), LED20.K (C), LED21.K (C), LED22.K (C), LED23.K (C), LED24.K (C), S1.1, S2.1, S3.1, S4.1, S5.1, S6.1, S7.1, S8.1, S9.1, S10.1, S11.1, S12.1, S13.1, S14.1, S15.1, S16.1, S17.1, S18.1, S19.1, S20.1, S21.1, S22.1, S23.1, S24.1, SHIFT.9
ID: IC1.9 (QH), SHIFT.7
IG: IC1.1 (SH/!LD), IC2.1 (SH/!LD), IC3.1 (SH/!LD), SHIFT.8
unnamed: IC4.15 (QA), R1.1
unnamed: IC4.1 (QB), R2.1
unnamed: IC4.2 (QC), R3.1
unnamed: IC4.3 (QD), R4.1
unnamed: IC4.4 (QE), R5.1
unnamed: IC4.5 (QF), R6.1
unnamed: IC4.6 (QG), R7.1
unnamed: IC4.7 (QH), R8.1
unnamed: IC5.15 (QA), R9.1
unnamed: IC5.1 (QB), R10.1
unnamed: IC5.2 (QC), R11.1
unnamed: IC5.3 (QD), R12.1
unnamed: IC5.4 (QE), R13.1
unnamed: IC5.5 (QF), R14.1
unnamed: IC5.6 (QG), R15.1
unnamed: IC5.7 (QH), R16.1
unnamed: IC6.15 (QA), R17.1
unnamed: IC6.1 (QB), R18.1
unnamed: IC6.2 (QC), R19.1
unnamed: IC6.3 (QD), R20.1
unnamed: IC6.4 (QE), R21.1
unnamed: IC6.5 (QF), R22.1
unnamed: IC6.6 (QG), R23.1
unnamed: IC6.7 (QH), R24.1
unnamed: LED1.A, R1.2
unnamed: LED2.A, R2.2
unnamed: LED3.A, R3.2
unnamed: LED4.A, R4.2
unnamed: LED5.A, R5.2
unnamed: LED6.A, R6.2
unnamed: LED7.A, R7.2
unnamed: LED8.A, R8.2
unnamed: LED9.A, R9.2
unnamed: LED10.A, R10.2
unnamed: LED11.A, R11.2
unnamed: LED12.A, R12.2
unnamed: LED13.A, R13.2
unnamed: LED14.A, R14.2
unnamed: LED15.A, R15.2
unnamed: LED16.A, R16.2
unnamed: IC4.9 (QH*), IC5.14 (SER)
unnamed: LED17.A, R17.2
unnamed: LED18.A, R18.2
unnamed: LED19.A, R19.2
unnamed: LED20.A, R20.2
unnamed: LED21.A, R21.2
unnamed: LED22.A, R22.2
unnamed: LED23.A, R23.2
unnamed: LED24.A, R24.2
unnamed: IC5.9 (QH*), IC6.14 (SER)
unnamed: IC1.11 (A), R25.1, S1.2 (S)
unnamed: IC1.12 (B), R26.1, S2.2 (S)
unnamed: IC1.13 (C), R27.1, S3.2 (S)
unnamed: IC1.14 (D), R28.1, S4.2 (S)
unnamed: IC1.3 (E), R29.1, S5.2 (S)
unnamed: IC1.4 (F), R30.1, S6.2 (S)
unnamed: IC1.5 (G), R31.1, S7.2 (S)
unnamed: IC1.6 (H), R32.1, S8.2 (S)
unnamed: IC2.11 (A), R33.1, S9.2 (S)
unnamed: IC2.12 (B), R34.1, S10.2 (S)
unnamed: IC2.13 (C), R35.1, S11.2 (S)
unnamed: IC2.14 (D), R36.1, S12.2 (S)
unnamed: IC2.3 (E), R37.1, S13.2 (S)
unnamed: IC2.4 (F), R38.1, S14.2 (S)
unnamed: IC2.5 (G), R39.1, S15.2 (S)
unnamed: IC2.6 (H), R40.1, S16.2 (S)
unnamed: IC3.11 (A), R41.1, S17.2 (S)
unnamed: IC3.12 (B), R42.1, S18.2 (S)
unnamed: IC3.13 (C), R43.1, S19.2 (S)
unnamed: IC3.14 (D), R44.1, S20.2 (S)
unnamed: IC3.3 (E), R45.1, S21.2 (S)
unnamed: IC3.4 (F), R46.1, S22.2 (S)
unnamed: IC3.5 (G), R47.1, S23.2 (S)
unnamed: IC3.6 (H), R48.1, S24.2 (S)
unnamed: IC1.10 (SER), IC2.9 (QH), R49.1
unnamed: IC2.10 (SER), IC3.9 (QH), R50.1
unnamed: IC3.10 (SER), R51.1
OD: IC4.14 (SER), SHIFT.4
OS: IC4.12 (RCK), IC5.12 (RCK), IC6.12 (RCK), SHIFT.5

Notes on the sheet:
LED 24 must be send out first.
Bit 00
Bit 01
Bit 02
Bit 03
Bit 04
Bit 07
Bit 05
Bit 06
Bit 08
Bit 09
Bit 10
Bit 11
Bit 12
Bit 13
Bit 14
Bit 15
Bit 16
Bit 17
Bit 18
Bit 19
Bit 20
Bit 21
Bit 22
Bit 23
Switch S24 will be read in last.
