DTzschentke/PCBs/Prototype/Fatar Keyboard TP8S 61Keys.sch

## EAGLE design Prototype/Fatar Keyboard TP8S 61Keys.sch (2012-08-02)

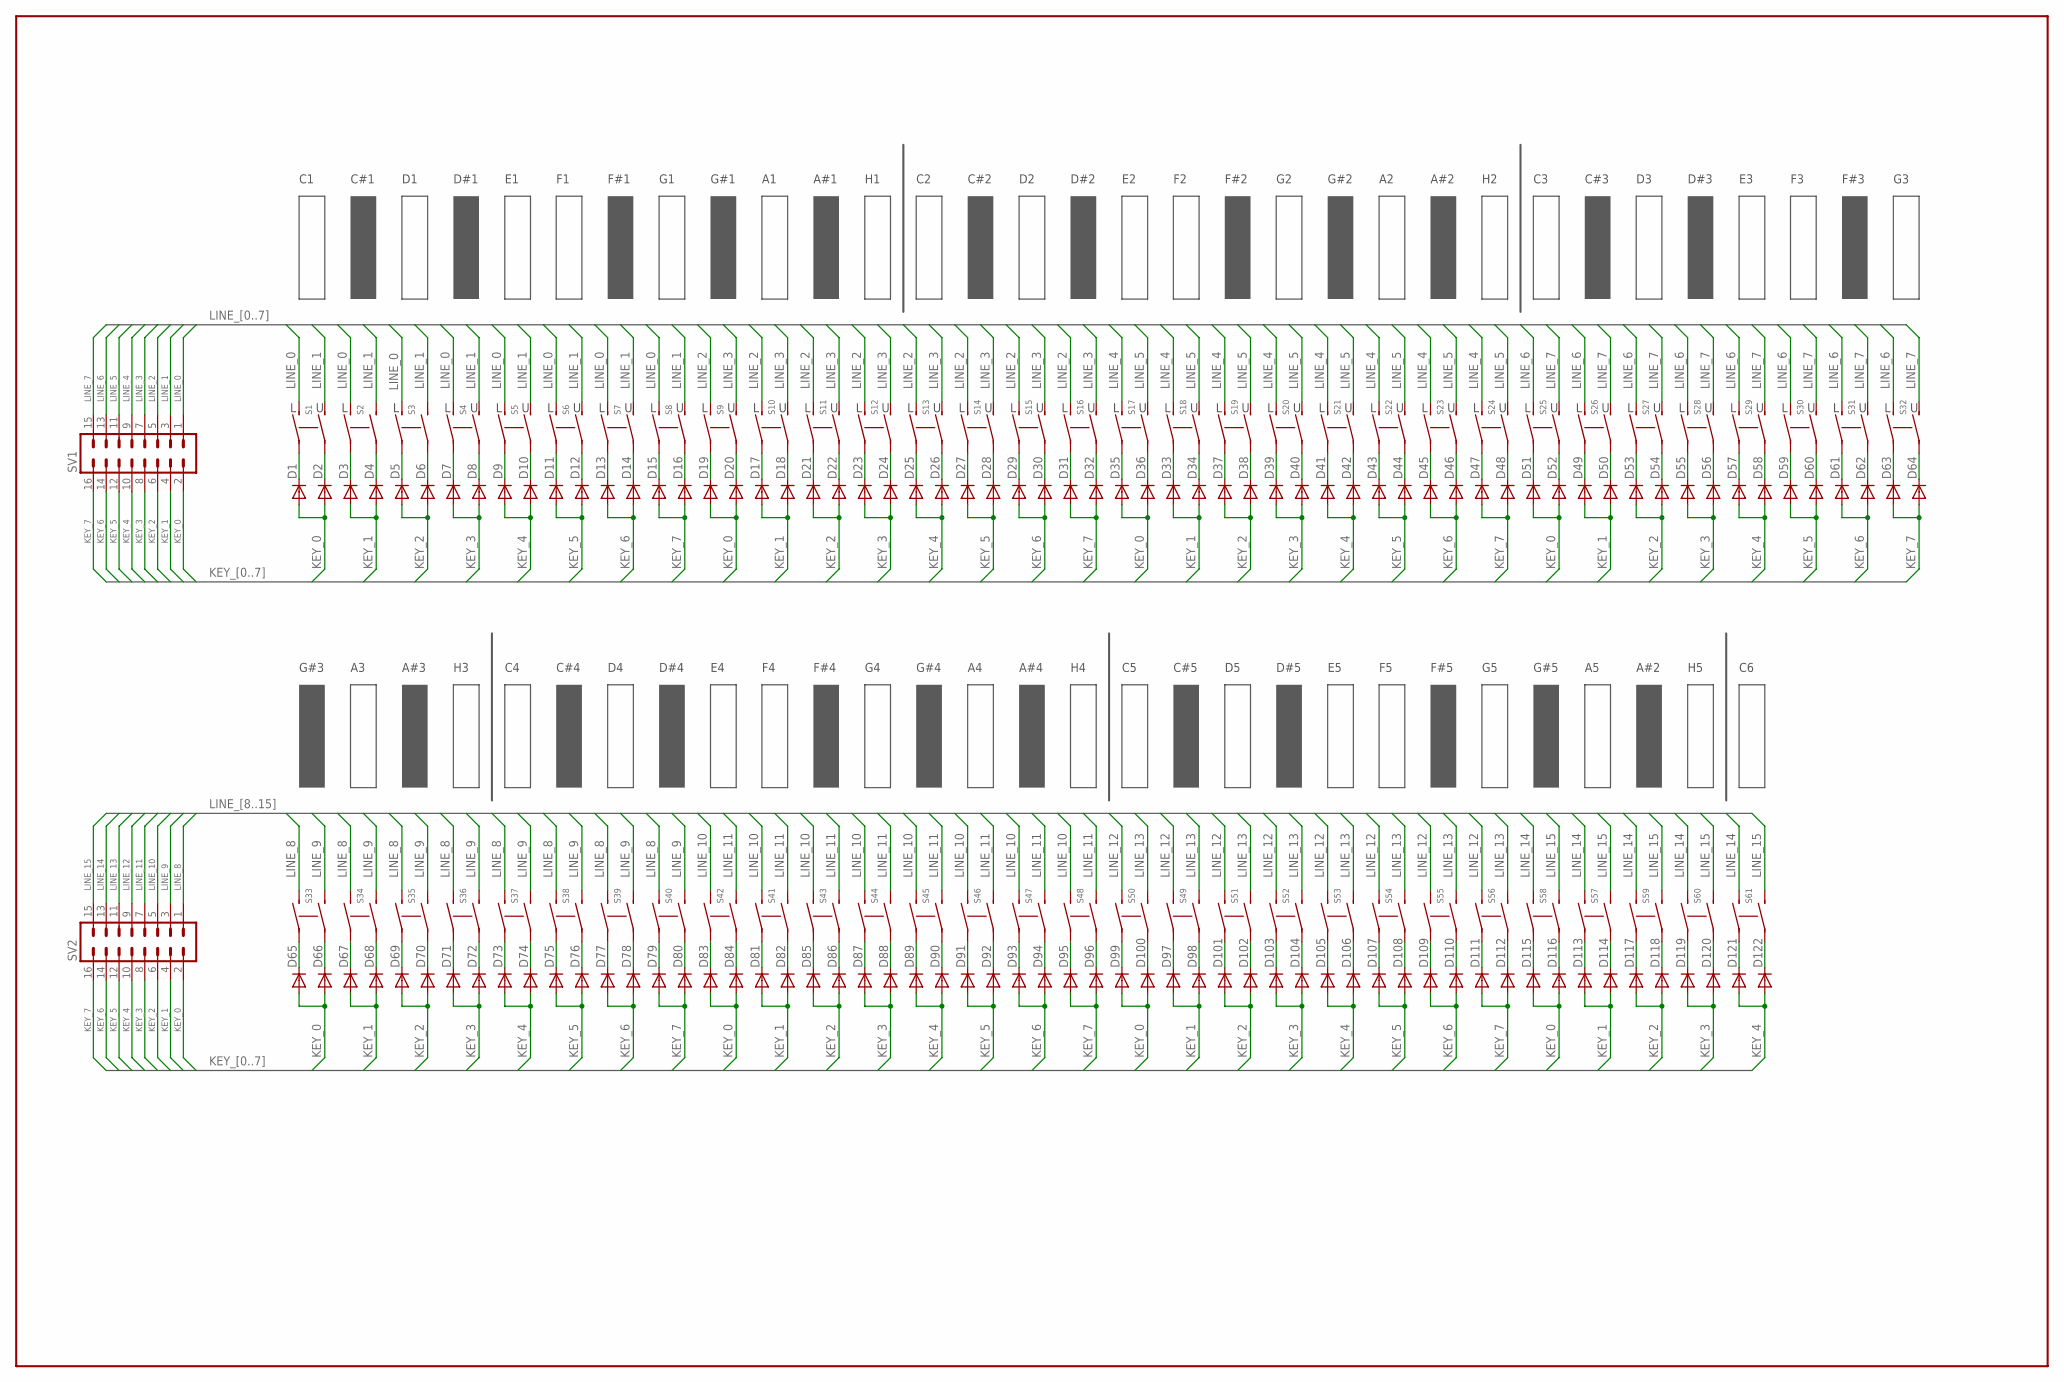
[picture p30: schematic Fatar Keyboard TP8S 61Keys.sch]

Parts:
D1, D2, D3, D4, D5, D6, D7, D8, D9, D10, D11, D12, D13, D14, D15, D16, D17, D18, D19, D20, D21, D22, D23, D24, D25, D26, D27, D28, D29, D30, D31, D32, D33, D34, D35, D36, D37, D38, D39, D40, D41, D42, D43, D44, D45, D46, D47, D48, D49, D50, D51, D52, D53, D54, D55, D56, D57, D58, D59, D60, D61, D62, D63, D64, D65, D66, D67, D68, D69, D70, D71, D72, D73, D74, D75, D76, D77, D78, D79, D80, D81, D82, D83, D84, D85, D86, D87, D88, D89, D90, D91, D92, D93, D94, D95, D96, D97, D98, D99, D100, D101, D102, D103, D104, D105, D106, D107, D108, D109, D110, D111, D112, D113, D114, D115, D116, D117, D118, D119, D120, D121, D122: 1N4148DO35-7; DO35-7
S1, S2, S3, S4, S5, S6, S7, S8, S9, S10, S11, S12, S13, S14, S15, S16, S17, S18, S19, S20, S21, S22, S23, S24, S25, S26, S27, S28, S29, S30, S31, S32, S33, S34, S35, S36, S37, S38, S39, S40, S41, S42, S43, S44, S45, S46, S47, S48, S49, S50, S51, S52, S53, S54, S55, S56, S57, S58, S59, S60, S61: PVA1; PVA1F
SV1, SV2: ML16

Connections:
KEY_0: D1.A, D2.A, D19.A, D20.A, D35.A, D36.A, D51.A, D52.A, D65.A, D66.A, D83.A, D84.A, D99.A, D100.A, D115.A, D116.A, SV1.2, SV2.2
KEY_1: D3.A, D4.A, D17.A, D18.A, D33.A, D34.A, D49.A, D50.A, D67.A, D68.A, D81.A, D82.A, D97.A, D98.A, D113.A, D114.A, SV1.4, SV2.4
KEY_2: D5.A, D6.A, D21.A, D22.A, D37.A, D38.A, D53.A, D54.A, D69.A, D70.A, D85.A, D86.A, D101.A, D102.A, D117.A, D118.A, SV1.6, SV2.6
KEY_3: D7.A, D8.A, D23.A, D24.A, D39.A, D40.A, D55.A, D56.A, D71.A, D72.A, D87.A, D88.A, D103.A, D104.A, D119.A, D120.A, SV1.8, SV2.8
KEY_4: D9.A, D10.A, D25.A, D26.A, D41.A, D42.A, D57.A, D58.A, D73.A, D74.A, D89.A, D90.A, D105.A, D106.A, D121.A, D122.A, SV1.10, SV2.10
KEY_5: D11.A, D12.A, D27.A, D28.A, D43.A, D44.A, D59.A, D60.A, D75.A, D76.A, D91.A, D92.A, D107.A, D108.A, SV1.12, SV2.12
KEY_6: D13.A, D14.A, D29.A, D30.A, D45.A, D46.A, D61.A, D62.A, D77.A, D78.A, D93.A, D94.A, D109.A, D110.A, SV1.14, SV2.14
KEY_7: D15.A, D16.A, D31.A, D32.A, D47.A, D48.A, D63.A, D64.A, D79.A, D80.A, D95.A, D96.A, D111.A, D112.A, SV1.16, SV2.16
LINE_0: S1.4 (S1), S2.4 (S1), S3.4 (S1), S4.4 (S1), S5.4 (S1), S6.4 (S1), S7.4 (S1), S8.4 (S1), SV1.1
LINE_1: S1.3 (S), S2.3 (S), S3.3 (S), S4.3 (S), S5.3 (S), S6.3 (S), S7.3 (S), S8.3 (S), SV1.3
LINE_2: S9.4 (S1), S10.4 (S1), S11.4 (S1), S12.4 (S1), S13.4 (S1), S14.4 (S1), S15.4 (S1), S16.4 (S1), SV1.5
LINE_3: S9.3 (S), S10.3 (S), S11.3 (S), S12.3 (S), S13.3 (S), S14.3 (S), S15.3 (S), S16.3 (S), SV1.7
LINE_4: S17.4 (S1), S18.4 (S1), S19.4 (S1), S20.4 (S1), S21.4 (S1), S22.4 (S1), S23.4 (S1), S24.4 (S1), SV1.9
LINE_5: S17.3 (S), S18.3 (S), S19.3 (S), S20.3 (S), S21.3 (S), S22.3 (S), S23.3 (S), S24.3 (S), SV1.11
LINE_6: S25.4 (S1), S26.4 (S1), S27.4 (S1), S28.4 (S1), S29.4 (S1), S30.4 (S1), S31.4 (S1), S32.4 (S1), SV1.13
LINE_7: S25.3 (S), S26.3 (S), S27.3 (S), S28.3 (S), S29.3 (S), S30.3 (S), S31.3 (S), S32.3 (S), SV1.15
LINE_8: S33.4 (S1), S34.4 (S1), S35.4 (S1), S36.4 (S1), S37.4 (S1), S38.4 (S1), S39.4 (S1), S40.4 (S1), SV2.1
LINE_9: S33.3 (S), S34.3 (S), S35.3 (S), S36.3 (S), S37.3 (S), S38.3 (S), S39.3 (S), S40.3 (S), SV2.3
LINE_10: S41.4 (S1), S42.4 (S1), S43.4 (S1), S44.4 (S1), S45.4 (S1), S46.4 (S1), S47.4 (S1), S48.4 (S1), SV2.5
LINE_11: S41.3 (S), S42.3 (S), S43.3 (S), S44.3 (S), S45.3 (S), S46.3 (S), S47.3 (S), S48.3 (S), SV2.7
LINE_12: S49.4 (S1), S50.4 (S1), S51.4 (S1), S52.4 (S1), S53.4 (S1), S54.4 (S1), S55.4 (S1), S56.4 (S1), SV2.9
LINE_13: S49.3 (S), S50.3 (S), S51.3 (S), S52.3 (S), S53.3 (S), S54.3 (S), S55.3 (S), S56.3 (S), SV2.11
LINE_14: S57.4 (S1), S58.4 (S1), S59.4 (S1), S60.4 (S1), S61.4 (S1), SV2.13
LINE_15: S57.3 (S), S58.3 (S), S59.3 (S), S60.3 (S), S61.3 (S), SV2.15
unnamed: D1.C, S1.2 (P1)
unnamed: D2.C, S1.1
unnamed: D65.C, S33.2 (P1)
unnamed: D66.C, S33.1
unnamed: D67.C, S34.2 (P1)
unnamed: D3.C, S2.2 (P1)
unnamed: D4.C, S2.1
unnamed: D68.C, S34.1
unnamed: D7.C, S4.2 (P1)
unnamed: D8.C, S4.1
unnamed: D5.C, S3.2 (P1)
unnamed: D6.C, S3.1
unnamed: D69.C, S35.2 (P1)
unnamed: D70.C, S35.1
unnamed: D17.C, S10.2 (P1)
unnamed: D18.C, S10.1
unnamed: D9.C, S5.2 (P1)
unnamed: D10.C, S5.1
unnamed: D71.C, S36.2 (P1)
unnamed: D72.C, S36.1
unnamed: D19.C, S9.2 (P1)
unnamed: D11.C, S6.2 (P1)
unnamed: D12.C, S6.1
unnamed: D73.C, S37.2 (P1)
unnamed: D20.C, S9.1
unnamed: D74.C, S37.1
unnamed: D13.C, S7.2 (P1)
unnamed: D14.C, S7.1
unnamed: D75.C, S38.2 (P1)
unnamed: D76.C, S38.1
unnamed: D77.C, S39.2 (P1)
unnamed: D15.C, S8.2 (P1)
unnamed: D16.C, S8.1
unnamed: D78.C, S39.1
unnamed: D21.C, S11.2 (P1)
unnamed: D22.C, S11.1
unnamed: D79.C, S40.2 (P1)
unnamed: D23.C, S12.2 (P1)
unnamed: D24.C, S12.1
unnamed: D80.C, S40.1
unnamed: D25.C, S13.2 (P1)
unnamed: D26.C, S13.1
unnamed: D81.C, S41.2 (P1)
unnamed: D27.C, S14.2 (P1)
unnamed: D28.C, S14.1
unnamed: D82.C, S41.1
unnamed: D29.C, S15.2 (P1)
unnamed: D30.C, S15.1
unnamed: D83.C, S42.2 (P1)
unnamed: D31.C, S16.2 (P1)
unnamed: D32.C, S16.1
unnamed: D84.C, S42.1
unnamed: D33.C, S18.2 (P1)
unnamed: D34.C, S18.1
unnamed: D85.C, S43.2 (P1)
unnamed: D35.C, S17.2 (P1)
unnamed: D36.C, S17.1
unnamed: D86.C, S43.1
unnamed: D87.C, S44.2 (P1)
unnamed: D88.C, S44.1
unnamed: D37.C, S19.2 (P1)
unnamed: D38.C, S19.1
unnamed: D89.C, S45.2 (P1)
unnamed: D39.C, S20.2 (P1)
unnamed: D40.C, S20.1
unnamed: D90.C, S45.1
unnamed: D41.C, S21.2 (P1)
unnamed: D42.C, S21.1
unnamed: D91.C, S46.2 (P1)
unnamed: D43.C, S22.2 (P1)
unnamed: D44.C, S22.1
unnamed: D92.C, S46.1
unnamed: D45.C, S23.2 (P1)
unnamed: D46.C, S23.1
unnamed: D93.C, S47.2 (P1)
unnamed: D47.C, S24.2 (P1)
unnamed: D48.C, S24.1
unnamed: D94.C, S47.1
unnamed: D49.C, S26.2 (P1)
unnamed: D50.C, S26.1
unnamed: D95.C, S48.2 (P1)
unnamed: D51.C, S25.2 (P1)
unnamed: D52.C, S25.1
unnamed: D96.C, S48.1
unnamed: D97.C, S49.2 (P1)
unnamed: D98.C, S49.1
unnamed: D53.C, S27.2 (P1)
unnamed: D54.C, S27.1
unnamed: D99.C, S50.2 (P1)
unnamed: D55.C, S28.2 (P1)
unnamed: D56.C, S28.1
unnamed: D100.C, S50.1
unnamed: D57.C, S29.2 (P1)
unnamed: D58.C, S29.1
unnamed: D101.C, S51.2 (P1)
unnamed: D59.C, S30.2 (P1)
unnamed: D60.C, S30.1
unnamed: D102.C, S51.1
unnamed: D61.C, S31.2 (P1)
unnamed: D62.C, S31.1
unnamed: D103.C, S52.2 (P1)
unnamed: D63.C, S32.2 (P1)
unnamed: D64.C, S32.1
unnamed: D104.C, S52.1
unnamed: D105.C, S53.2 (P1)
unnamed: D106.C, S53.1
unnamed: D107.C, S54.2 (P1)
unnamed: D108.C, S54.1
unnamed: D109.C, S55.2 (P1)
unnamed: D110.C, S55.1
unnamed: D111.C, S56.2 (P1)
unnamed: D112.C, S56.1
unnamed: D113.C, S57.2 (P1)
unnamed: D114.C, S57.1
unnamed: D115.C, S58.2 (P1)
unnamed: D116.C, S58.1
unnamed: D117.C, S59.2 (P1)
unnamed: D118.C, S59.1
unnamed: D119.C, S60.2 (P1)
unnamed: D120.C, S60.1
unnamed: D121.C, S61.2 (P1)
unnamed: D122.C, S61.1

Notes on the sheet:
C#1
D#1
F#1
G#1
A#1
C#2
D#2
F#2
G#2
A#2
C#3
D#3
F#3
G#3
A#3
C#4
D#4
F#4
G#4
A#4
C#5
D#5
F#5
G#5
